kavionic/SAME70CPad/Schematics/Notes.ods

Sheet: Pin assignment
LQFP Pin | Primary |  |  | Alternate |  | PIO Peripheral A |  | PIO Peripheral B |  | PIO Peripheral C |  | PIO Peripheral D |  | Reset State
 | Signal | Peripheral | Peripheral Signal | Signal | Dir | Signal | Dir | Signal | Dir | Signal | Dir | Signal | Dir | Signal, Dir, PU, PD, HiZ, ST
102 | PA0 | SDRAM | SDRAM_BANK1 | WKUP0(1) | I | PWMC0_PWMH0 | O | TIOA0 | I/O | A17/BA1 | O | I2SC0_MCK | – | PIO,I,PU,ST
99 | PA1 | IMU | IMU_INT [IW] | WKUP1(1) | I | PWMC0_PWML0 | O | TIOB0 | I/O | A18 | O | I2SC0_CK | – | PIO,I,PU,ST
93 | PA2 | TOUCHSCR | CTP_INT [IW] | WKUP2(1) | I | PWMC0_PWMH1 | O | – | – | DATRG | I | – | – | PIO,I,PU,ST
91 | PA3 | TOUCHSCR | CTP_SDA | PIODC0(2) | I | TWD0 | I/O | LONCOL1 | I | PCK2 | O | – | – | PIO,I,PU,ST
77 | PA4 | TOUCHSCR | CTP_SCL | WKUP3/PIODC1(3) | I | TWCK0 | O | TCLK0 | I | UTXD1 | O | – | – | PIO,I,PU,ST
73 | PA5 | WIFI | WIFI_TX | WKUP4/PIODC2(3) | I | PWMC1_PWML3 | O | ISI_D4 | I | URXD1 | I | – | – | PIO,I,PU,ST
114 | PA6 | WIFI | WIFI_RX | – | – | – | – | PCK0 | O | UTXD1 | O | – | – | PIO,I,PU,ST
35 | PA7 | OSCILLATOR | Xtal 32768 | XIN32(4) | I | – | – | PWMC0_PWMH3 | O | – | – | – | – | PIO,HiZ
36 | PA8 | OSCILLATOR | Xtal 32768 | XOUT32(4) | O | PWMC1_PWMH3 | O | AFE0_ADTRG | I | – | – | – | – | PIO,HiZ
75 | PA9 | USB | VBUS_DETECT [IW] | WKUP6/PIODC3(3) | I | URXD0 | I | ISI_D3 | I | PWMC0_PWMFI0 | I | – | – | PIO,I,PU,ST
66 | PA10 | AUDIO | AUDIO_DOUT | PIODC4(2) | I | UTXD0 | O | PWMC0_PWMEXTRG0 | I | RD | I | – | – | PIO,I,PU,ST
64 | PA11 | FLASH | QSPI_CE | WKUP7/PIODC5(3) | I | QCS | O | PWMC0_PWMH0 | O | PWMC1_PWML0 | O | – | – | PIO,I,PU,ST
68 | PA12 | FLASH | QSPI_IO1 | PIODC6(2) | I | QIO1 | I/O | PWMC0_PWMH1 | O | PWMC1_PWMH0 | O | – | – | PIO,I,PU,ST
42 | PA13 | FLASH | QSPI_IO0 | PIODC7(2) | I | QIO0 | I/O | PWMC0_PWMH2 | O | PWMC1_PWML1 | O | – | – | PIO,I,PU,ST
51 | PA14 | FLASH | QSPI_SCK | WKUP8/PIODCEN1(3) | I | QSCK | O | PWMC0_PWMH3 | O | PWMC1_PWMH1 | O | – | – | PIO,I,PU,ST
49 | PA15 | SDRAM/LCD | DB14 | – | – | D14 | I/O | TIOA1 | I/O | PWMC0_PWML3 | O | I2SC0_WS | – | PIO,I,PU,ST
45 | PA16 | SDRAM/LCD | DB15 | – | – | D15 | I/O | TIOB1 | I/O | PWMC0_PWML2 | O | I2SC0_DI | – | PIO,I,PU,ST
25 | PA17 | FLASH | QSPI_IO2 | AFE0_AD6(5) | I | QIO2 | I/O | PCK1 | O | PWMC0_PWMH3 | O | – | – | PIO,I,PU,ST
24 | PA18 | SDRAM | AB14 | AFE0_AD7(5) | I | PWMC1_PWMEXTRG1 | I | PCK2 | O | A14 | O | – | – | PIO,I,PU,ST
23 | PA19 | SYSTEM | POWER_SW [IW] | AFE0_AD8/WKUP9(6) | I | – | – | PWMC0_PWML0 | O | A15 | O | I2SC1_MCK | – | PIO,I,PU,ST
22 | PA20 | SDRAM | SDRAM_BANK0 | AFE0_AD9/WKUP10(6) | I | – | – | PWMC0_PWML1 | O | A16/BA0 | O | I2SC1_CK | – | PIO,I,PU,ST
32 | PA21 | AUDIO | AUDIO_MCLK | AFE0_AD1/PIODCEN2(8) | I | RXD1 | I | PCK1 | O | PWMC1_PWMFI0 | I | – | – | PIO,I,PU,ST
37 | PA22 | TOUCHSCR | CTP_RESET [GPIO] | PIODCCLK(2) | I | RK | I/O | PWMC0_PWMEXTRG1 | I | NCS2 | O | – | – | PIO,I,PU,ST
46 | PA23 | TOUCHSCR | CTP_WAKE [GPIO] | – | – | SCK1 | I/O | PWMC0_PWMH0 | O | A19 | O | PWMC1_PWML2 | O | PIO,I,PU,ST
56 | PA24 | SDCARD | SDC_CD [GPIO] | – | – | RTS1 | O | PWMC0_PWMH1 | O | A20 | O | ISI_PCK | I | PIO,I,PU,ST
59 | PA25 | SDCARD | SDC_CLK | – | – | CTS1 | I | PWMC0_PWMH2 | O | A23 | O | MCCK | O | PIO,I,PU,ST
62 | PA26 | SDCARD | SDC_DATA2 | – | – | DCD1 | I | TIOA2 | O | MCDA2 | I/O | PWMC1_PWMFI1 | I | PIO,I,PU,ST
70 | PA27 | SDCARD | SDC_DATA3 | – | – | DTR1 | O | TIOB2 | I/O | MCDA3 | I/O | ISI_D7 | I | PIO,I,PU,ST
112 | PA28 | SDCARD | SDC_CMD | – | – | DSR1 | I | TCLK1 | I | MCCDA | I/O | PWMC1_PWMFI2 | I | PIO,I,PU,ST
129 | PA29 | IMU | IMU_FSYNC [GPIO] | – | – | RI1 | I | TCLK2 | I | – | – | – | – | PIO,I,PU,ST
116 | PA30 | SDCARD | SDC_DATA0 | WKUP11(1) | I | PWMC0_PWML2 | O | PWMC1_PWMEXTRG0 | I | MCDA0 | I/O | I2SC0_DO | – | PIO,I,PU,ST
118 | PA31 | SDCARD | SDC_DATA1 | – | – | SPI0_NPCS1 | I/O | PCK2 | O | MCDA1 | I/O | PWMC1_PWMH2 | O | PIO,I,PU,ST
21 | PB0 | AUDIO | AUDIO_WCLK | AFE0_AD10/RTCOUT0(7) | I | PWMC0_PWMH0 | O | – | – | RXD0 | I | TF | I/O | PIO,I,PU,ST
20 | PB1 | AUDIO | AUDIO_BCLK | AFE1_AD0/RTCOUT1(7) | I | PWMC0_PWMH1 | O | GTSUCOMP | O | TXD0 | I/O | TK | I/O | PIO,I,PU,ST
26 | PB2 | USB | VBUS_MEASURE [A] | AFE0_AD5(5) | I | CANTX0 | O | – | – | CTS0 | I | SPI0_NPCS0 | I/O | PIO,I,PU,ST
31 | PB3 | RF24 | RF24_IRQ [IW] | AFE0_AD2/WKUP12(6) | I | CANRX0 | I | PCK2 | O | RTS0 | O | ISI_D2 | I | PIO,I,PU,ST
105 | PB4 | SWD/JTAG | DBG_TDI | TDI(9) | I | TWD1 | I/O | PWMC0_PWMH2 | O | – | – | TXD1 | I/O | PIO,I,PD,ST
109 | PB5 | SWD/JTAG | DBG_TRACESWO | TDO/TRACESWO/WKUP13(9) | O | TWCK1 | O | PWMC0_PWML0 | O | – | – | TD | O | O,PU
79 | PB6 | SWD/JTAG | DBG_SWDIO | SWDIO/TMS(9) | I | – | – | – | – | – | – | – | – | PIO,I,ST
89 | PB7 | SWD/JTAG | DBG_SWCLK | SWCLK/TCK(9) | I | – | – | – | – | – | – | – | – | PIO,I,ST
141 | PB8 | OSCILLATOR | Xtal 12MHz | XOUT(10) | O | – | – | – | – | – | – | – | – | PIO,HiZ
142 | PB9 | OSCILLATOR | Xtal 12MHz | XIN(10) | I | – | – | – | – | – | – | – | – | PIO,HiZ
87 | PB12 | UDB | USB_ID [GPIO] | ERASE(9) | I | PWMC0_PWML1 | O | GTSUCOMP | O | – | – | PCK0 | O | PIO,I,PD,ST
144 | PB13 | VREF | VREF_SHDN [GPIO] | DAC0(11) | O | PWMC0_PWML2 | O | PCK0 | O | SCK0 | I/O | – | – | PIO,I,PU,ST
11 | PC0 | SDRAM/LCD | DB0 | AFE1_AD9(5) | I | D0 | I/O | PWMC0_PWML0 | O | – | – | – | – | PIO,I,PU,ST
38 | PC1 | SDRAM/LCD | DB1 | – | – | D1 | I/O | PWMC0_PWML1 | O | – | – | – | – | PIO,I,PU,ST
39 | PC2 | SDRAM/LCD | DB2 | – | – | D2 | I/O | PWMC0_PWML2 | O | – | – | – | – | PIO,I,PU,ST
40 | PC3 | SDRAM/LCD | DB3 | – | – | D3 | I/O | PWMC0_PWML3 | O | – | – | – | – | PIO,I,PU,ST
41 | PC4 | SDRAM/LCD | DB4 | – | – | D4 | I/O | – | – | – | – | – | – | PIO,I,PU,ST
58 | PC5 | SDRAM/LCD | DB5 | – | – | D5 | I/O | TIOA6 | I/O | – | – | – | – | PIO,I,PU,ST
54 | PC6 | SDRAM/LCD | DB6 | – | – | D6 | I/O | TIOB6 | I/O | – | – | – | – | PIO,I,PU,ST
48 | PC7 | SDRAM/LCD | DB7 | – | – | D7 | I/O | TCLK6 | I | – | – | – | – | PIO,I,PU,ST
82 | PC8 | LCD | LCD_WR | – | – | NWR0/NWE | O | TIOA7 | I/O | – | – | – | – | PIO,I,PU,ST
86 | PC9 | LCD | LCD_WAIT [GPIO] | – | – | NANDOE | O | TIOB7 | I/O | – | – | – | – | PIO,I,PU,ST
90 | PC10 | LCD | LCD_RESET [GPIO] | – | – | NANDWE | O | TCLK7 | I | – | – | – | – | PIO,I,PU,ST
94 | PC11 | LCD | LCD_RD | – | – | NRD | O | TIOA8 | I/O | – | – | – | – | PIO,I,PU,ST
17 | PC12 | LCD | LCD_CS | AFE1_AD3(5) | I | NCS3 | O | TIOB8 | I/O | CANRX1 | I | – | – | PIO,I,PU,ST
19 | PC13 | CHARGER | PWR_CHG_OTG [GPIO] | AFE1_AD1(5) | I | NWAIT | I | PWMC0_PWMH3 | O | SDA10 | O | – | – | PIO,I,PU,ST
97 | PC14 | LCD | LCD_INT [I] | – | – | NCS0 | O | TCLK8 | I | CANTX1 | O | – | – | PIO,I,PU,ST
18 | PC15 | SDRAM | SDRAM_CS | AFE1_AD2(5) | I | NCS1/SDCS | O | PWMC0_PWML3 | O | – | – | – | – | PIO,I,PU,ST
100 | PC16 | LCD | LCD_C86 [GPIO] | – | – | A21/NANDALE | O | – | – | – | – | – | – | PIO,I,PU,ST
103 | PC17 | CHARGER | PWR_CHG_INT [I] | – | – | A22/NANDCLE | O | – | – | – | – | – | – | PIO,I,PU,ST
111 | PC18 | SDRAM | DQML | – | – | A0/NBS0 | O | PWMC0_PWML1 | O | – | – | – | – | PIO,I,PU,ST
117 | PC19 | LCD | LCD_RS | – | – | A1 | O | PWMC0_PWMH2 | O | – | – | – | – | PIO,I,PU,ST
120 | PC20 | SDRAM | AB2 | – | – | A2 | O | PWMC0_PWML2 | O | – | – | – | – | PIO,I,PU,ST
122 | PC21 | SDRAM | AB3 | – | – | A3 | O | PWMC0_PWMH3 | O | – | – | – | – | PIO,I,PU,ST
124 | PC22 | SDRAM | AB4 | – | – | A4 | O | PWMC0_PWML3 | O | – | – | – | – | PIO,I,PU,ST
127 | PC23 | SDRAM | AB5 | – | – | A5 | O | TIOA3 | I/O | – | – | – | – | PIO,I,PU,ST
130 | PC24 | SDRAM | AB6 | – | – | A6 | O | TIOB3 | I/O | SPI1_SPCK | O | – | – | PIO,I,PU,ST
133 | PC25 | SDRAM | AB7 | – | – | A7 | O | TCLK3 | I | SPI1_NPCS0 | I/O | – | – | PIO,I,PU,ST
13 | PC26 | SDRAM | AB8 | AFE1_AD7(5) | I | A8 | O | TIOA4 | I/O | SPI1_MISO | I | – | – | PIO,I,PU,ST
12 | PC27 | SDRAM | AB9 | AFE1_AD8(5) | I | A9 | O | TIOB4 | I/O | SPI1_MOSI | O | – | – | PIO,I,PU,ST
76 | PC28 | SDRAM | AB10 | – | – | A10 | O | TCLK4 | I | SPI1_NPCS1 | I/O | – | – | PIO,I,PU,ST
16 | PC29 | SDRAM | AB11 | AFE1_AD4(5) | I | A11 | O | TIOA5 | I/O | SPI1_NPCS2 | O | – | – | PIO,I,PU,ST
15 | PC30 | AUDIO | AUDIO_INT [I] | AFE1_AD5(5) | I | A12 | O | TIOB5 | I/O | SPI1_NPCS3 | O | – | – | PIO,I,PU,ST
14 | PC31 | SDRAM | AB13 | AFE1_AD6(5) | I | A13 | O | TCLK5 | I | – | – | – | – | PIO,I,PU,ST
1 | PD0 | AUDIO | AUDIO_RESET [GPIO] | DAC1(11) | I | GTXCK | I | PWMC1_PWML0 | O | SPI1_NPCS1 | I/O | DCD0 | I | PIO,I,PU,ST
132 | PD1 | LED | LED_R | – | – | GTXEN | O | PWMC1_PWMH0 | O | SPI1_NPCS2 | I/O | DTR0 | O | PIO,I,PU,ST
131 | PD2 | WIFI | WIFI_RESET [GPIO] | – | – | GTX0 | O | PWMC1_PWML1 | O | SPI1_NPCS3 | I/O | DSR0 | I | PIO,I,PU,ST
128 | PD3 | LED | LED_G | – | – | GTX1 | O | PWMC1_PWMH1 | O | UTXD4 | O | RI0 | I | PIO,I,PU,ST
126 | PD4 | WIFI | WIFI_FLASH [GPIO] | – | – | GRXDV | I | PWMC1_PWML2 | O | TRACED0 | O | DCD2 | I | PIO,I,PU,ST
125 | PD5 | LED | LED_B | – | – | GRX0 | I | PWMC1_PWMH2 | O | TRACED1 | O | DTR2 | O | PIO,I,PU,ST
121 | PD6 | WIFI | WIFI_EN [GPIO] | – | – | GRX1 | I | PWMC1_PWML3 | O | TRACED2 | O | DSR2 | I | PIO,I,PU,ST
119 | PD7 | 3V3_REG | PWR_VREGMODE [GPIO] | – | – | GRXER | I | PWMC1_PWMH3 | O | TRACED3 | O | RI2 | I | PIO,I,PU,ST
113 | PD8 | 5V_REG | PWR_5VEN [GPIO] | – | – | GMDC | O | PWMC0_PWMFI1 | I | – | – | TRACECLK | O | PIO,I,PU,ST
110 | PD9 | CHARGER | PWR_CHG_CHG_ENABLE [GPIO] | – | – | GMDIO | I/O | PWMC0_PWMFI2 | I | AFE1_ADTRG | I | – | – | PIO,I,PU,ST
101 | PD10 | AUDIO | AUDIO_DIN | – | – | GCRS | I | PWMC0_PWML0 | O | TD | O | – | – | PIO,I,PD,ST
98 | PD11 | LCD | LCD_BL_CTRL [PWM] | – | – | GRX2 | I | PWMC0_PWMH0 | O | GTSUCOMP | O | ISI_D5 | I | PIO,I,PU,ST
92 | PD12 | RF24 | RF24_CE | – | – | GRX3 | I | CANTX1 | O | SPI0_NPCS2 | O | ISI_D6 | I | PIO,I,PU,ST
88 | PD13 | SDRAM | SDA10 | – | – | GCOL | I | – | – | SDA10 | O | – | – | PIO,I,PU,ST
84 | PD14 | SDRAM | SDRAM_CKE | – | – | GRXCK | I | – | – | SDCKE | O | – | – | PIO,I,PU,ST
106 | PD15 | SDRAM | DQMH | – | – | GTX2 | O | RXD2 | I | NWR1/NBS1 | O | – | – | PIO,I,PU,ST
78 | PD16 | SDRAM | SDRAM_RAS | – | – | GTX3 | O | TXD2 | I/O | RAS | O | – | – | PIO,I,PU,ST
74 | PD17 | SDRAM | SDRAM_CAS | – | – | GTXER | O | SCK2 | I/O | CAS | O | – | – | PIO,I,PU,ST
69 | PD18 | UART | DBGUART_RX | – | – | NCS1/SDCS | O | RTS2 | O | URXD4 | I | – | – | PIO,I,PU,ST
67 | PD19 | UART | DBGUART_TX | – | – | NCS3 | O | CTS2 | I | UTXD4 | O | – | – | PIO,I,PU,ST
65 | PD20 | RF24 | RF24_MISO | – | – | PWMC0_PWMH0 | O | SPI0_MISO | I/O | GTSUCOMP | O | – | – | PIO,I,PU,ST
63 | PD21 | RF24 | RF24_MOSI | – | – | PWMC0_PWMH1 | O | SPI0_MOSI | I/O | TIOA11 | I/O | ISI_D1 | I | PIO,I,PU,ST
60 | PD22 | RF24 | RF24_SCK | – | – | PWMC0_PWMH2 | O | SPI0_SPCK | O | TIOB11 | I/O | ISI_D0 | I | PIO,I,PU,ST
57 | PD23 | SDRAM | SDRAM_CLK | – | – | PWMC0_PWMH3 | O | – | – | SDCK | O | – | – | PIO,I,PU,ST
55 | PD24 | FLASH | QSPI_RESET [GPIO] | – | – | PWMC0_PWML0 | O | RF | I/O | TCLK11 | I | ISI_HSYNC | I | PIO,I,PU,ST
52 | PD25 | RF24 | RF24_CSN | – | – | PWMC0_PWML1 | O | SPI0_NPCS1 | I/O | URXD2 | I | ISI_VSYNC | I | PIO,I,PU,ST
53 | PD26 | ISENS | ISENS_WARNING [I] | – | – | PWMC0_PWML2 | O | TD | O | UTXD2 | O | UTXD1 | O | PIO,I,PU,ST
47 | PD27 | I2CBUS | I2CBUS2_SDA | – | – | PWMC0_PWML3 | O | SPI0_NPCS3 | O | TWD2 | O | ISI_D8 | I | PIO,I,PU,ST
71 | PD28 | I2CBUS | I2CBUS2_SCL | WKUP5(1) | I | URXD3 | I | CANRX1 | I | TWCK2 | O | ISI_D9 | I | PIO,I,PU,ST
108 | PD29 | SDRAM | SDRAM_WE | – | – | – | – | – | – | SDWE | O | – | – | PIO,I,PU,ST
34 | PD30 | ISENS | ISENS_CRITICAL [I] | AFE0_AD0(5) | I | UTXD3 | 0 | – | – | – | – | ISI_D10 | I | PIO,I,PU,ST
2 | PD31 | FLASH | QSPI_IO3 | – | – | QIO3 | I/O | UTXD3 | O | PCK2 | O | ISI_D11 | I | PIO,I,PU,ST
4 | PE0 | SDRAM/LCD | DB8 | AFE1_AD11(5) | I | D8 | I/O | TIOA9 | I/O | I2SC1_WS | – | – | – | PIO,I,PU,ST
6 | PE1 | SDRAM/LCD | DB9 | – | – | D9 | I/O | TIOB9 | I/O | I2SC1_DO | – | – | – | PIO,I,PU,ST
7 | PE2 | SDRAM/LCD | DB10 | – | – | D10 | I/O | TCLK9 | I | I2SC1_DI | – | – | – | PIO,I,PU,ST
10 | PE3 | SDRAM/LCD | DB11 | AFE1_AD10(5) | I | D11 | I/O | TIOA10 | I/O | – | – | – | – | PIO,I,PU,ST
27 | PE4 | SDRAM/LCD | DB12 | AFE0_AD4(5) | I | D12 | I/O | TIOB10 | I/O | – | – | – | – | PIO,I,PU,ST
28 | PE5 | SDRAM/LCD | DB13 | AFE0_AD3(5) | I | D13 | I/O | TCLK10 | I/O | – | – | – | – | PIO,I,PU,ST
3 | VDDOUT | POWER |  | – | – | – | – | – | – | – | – | – | – | –
5 | VDDIN | POWER |  | – | – | – | – | – | – | – | – | – | – | –
8 | VREFN | VREF |  | – | – | – | – | – | – | – | – | – | – | –
9 | VREFP | VREF |  | – | – | – | – | – | – | – | – | – | – | –
83 | NRST | SYSTEM | RESET | – | – | – | – | – | – | – | – | – | – | I,PU
85 | TST | SYSTEM | TST | – | – | – | – | – | – | – | – | – | – | I,PD
30,43,72, 80,96 | VDDIO | POWER |  | – | – | – | – | – | – | – | – | – | – | –
104 | JTAGSEL | SYSTEM | JTAGSEL | – | – | – | – | – | – | – | – | – | – | I,PD
29,33,50, 81,107 | VDDCORE | POWER |  | – | – | – | – | – | – | – | – | – | – | –
123 | VDDPLL | POWER |  | – | – | – | – | – | – | – | – | – | – | –
134 | VDDUTMII | POWER |  | – | – | – | – | – | – | – | – | – | – | –
136 | HSDM | USB | USB_D- | – | – | – | – | – | – | – | – | – | – | –
137 | HSDP | USB | USB_D+ | – | – | – | – | – | – | – | – | – | – | –
44,61,95, 115,135,138 | GND | POWER |  | – | – | – | – | – | – | – | – | – | – | –
– | GNDANA | POWER |  | – | – | – | – | – | – | – | – | – | – | –
– | GNDUTMI | POWER |  | – | – | – | – | – | – | – | – | – | – | –
– | GNDPLLUSB | POWER |  | – | – | – | – | – | – | – | – | – | – | –
– | GNDPLL | POWER |  | – | – | – | – | – | – | – | – | – | – | –
139 | VDDUTMIC | POWER |  | – | – | – | – | – | – | – | – | – | – | –
140 | VBG | POWER |  | – | – | – | – | – | – | – | – | – | – | –
143 | VDDPLLUSB | POWER |  | – | – | – | – | – | – | – | – | – | – | –

Sheet: PinAss Periph
LQFP Pin | Primary |  |  | Alternate |  | PIO Peripheral A |  | PIO Peripheral B |  | PIO Peripheral C |  | PIO Peripheral D |  | Reset State
 | Signal | Peripheral | Peripheral Signal | Signal | Dir | Signal | Dir | Signal | Dir | Signal | Dir | Signal | Dir | Signal, Dir, PU, PD, HiZ, ST
119 | PD7 | 3V3_REG | PWR_VREGMODE [GPIO] | – | – | GRXER | I | PWMC1_PWMH3 | O | TRACED3 | O | RI2 | I | PIO,I,PU,ST
113 | PD8 | 5V_REG | PWR_5VEN [GPIO] | – | – | GMDC | O | PWMC0_PWMFI1 | I | – | – | TRACECLK | O | PIO,I,PU,ST
20 | PB1 | AUDIO | AUDIO_BCLK | AFE1_AD0/RTCOUT1(7) | I | PWMC0_PWMH1 | O | GTSUCOMP | O | TXD0 | I/O | TK | I/O | PIO,I,PU,ST
101 | PD10 | AUDIO | AUDIO_DIN | – | – | GCRS | I | PWMC0_PWML0 | O | TD | O | – | – | PIO,I,PD,ST
66 | PA10 | AUDIO | AUDIO_DOUT | PIODC4(2) | I | UTXD0 | O | PWMC0_PWMEXTRG0 | I | RD | I | – | – | PIO,I,PU,ST
15 | PC30 | AUDIO | AUDIO_INT [I] | AFE1_AD5(5) | I | A12 | O | TIOB5 | I/O | SPI1_NPCS3 | O | – | – | PIO,I,PU,ST
32 | PA21 | AUDIO | AUDIO_MCLK | AFE0_AD1/PIODCEN2(8) | I | RXD1 | I | PCK1 | O | PWMC1_PWMFI0 | I | – | – | PIO,I,PU,ST
1 | PD0 | AUDIO | AUDIO_RESET [GPIO] | DAC1(11) | I | GTXCK | I | PWMC1_PWML0 | O | SPI1_NPCS1 | I/O | DCD0 | I | PIO,I,PU,ST
21 | PB0 | AUDIO | AUDIO_WCLK | AFE0_AD10/RTCOUT0(7) | I | PWMC0_PWMH0 | O | – | – | RXD0 | I | TF | I/O | PIO,I,PU,ST
110 | PD9 | CHARGER | PWR_CHG_CHG_ENABLE [GPIO] | – | – | GMDIO | I/O | PWMC0_PWMFI2 | I | AFE1_ADTRG | I | – | – | PIO,I,PU,ST
103 | PC17 | CHARGER | PWR_CHG_INT [I] | – | – | A22/NANDCLE | O | – | – | – | – | – | – | PIO,I,PU,ST
19 | PC13 | CHARGER | PWR_CHG_OTG [GPIO] | AFE1_AD1(5) | I | NWAIT | I | PWMC0_PWMH3 | O | SDA10 | O | – | – | PIO,I,PU,ST
64 | PA11 | FLASH | QSPI_CE | WKUP7/PIODC5(3) | I | QCS | O | PWMC0_PWMH0 | O | PWMC1_PWML0 | O | – | – | PIO,I,PU,ST
42 | PA13 | FLASH | QSPI_IO0 | PIODC7(2) | I | QIO0 | I/O | PWMC0_PWMH2 | O | PWMC1_PWML1 | O | – | – | PIO,I,PU,ST
68 | PA12 | FLASH | QSPI_IO1 | PIODC6(2) | I | QIO1 | I/O | PWMC0_PWMH1 | O | PWMC1_PWMH0 | O | – | – | PIO,I,PU,ST
25 | PA17 | FLASH | QSPI_IO2 | AFE0_AD6(5) | I | QIO2 | I/O | PCK1 | O | PWMC0_PWMH3 | O | – | – | PIO,I,PU,ST
2 | PD31 | FLASH | QSPI_IO3 | – | – | QIO3 | I/O | UTXD3 | O | PCK2 | O | ISI_D11 | I | PIO,I,PU,ST
55 | PD24 | FLASH | QSPI_RESET [GPIO] | – | – | PWMC0_PWML0 | O | RF | I/O | TCLK11 | I | ISI_HSYNC | I | PIO,I,PU,ST
51 | PA14 | FLASH | QSPI_SCK | WKUP8/PIODCEN1(3) | I | QSCK | O | PWMC0_PWMH3 | O | PWMC1_PWMH1 | O | – | – | PIO,I,PU,ST
71 | PD28 | I2CBUS | I2CBUS2_SCL | WKUP5(1) | I | URXD3 | I | CANRX1 | I | TWCK2 | O | ISI_D9 | I | PIO,I,PU,ST
47 | PD27 | I2CBUS | I2CBUS2_SDA | – | – | PWMC0_PWML3 | O | SPI0_NPCS3 | O | TWD2 | O | ISI_D8 | I | PIO,I,PU,ST
129 | PA29 | IMU | IMU_FSYNC [GPIO] | – | – | RI1 | I | TCLK2 | I | – | – | – | – | PIO,I,PU,ST
99 | PA1 | IMU | IMU_INT [IW] | WKUP1(1) | I | PWMC0_PWML0 | O | TIOB0 | I/O | A18 | O | I2SC0_CK | – | PIO,I,PU,ST
34 | PD30 | ISENS | ISENS_CRITICAL [I] | AFE0_AD0(5) | I | UTXD3 | 0 | – | – | – | – | ISI_D10 | I | PIO,I,PU,ST
53 | PD26 | ISENS | ISENS_WARNING [I] | – | – | PWMC0_PWML2 | O | TD | O | UTXD2 | O | UTXD1 | O | PIO,I,PU,ST
125 | PD5 | LED | LED_B | – | – | GRX0 | I | PWMC1_PWMH2 | O | TRACED1 | O | DTR2 | O | PIO,I,PU,ST
128 | PD3 | LED | LED_G | – | – | GTX1 | O | PWMC1_PWMH1 | O | UTXD4 | O | RI0 | I | PIO,I,PU,ST
132 | PD1 | LED | LED_R | – | – | GTXEN | O | PWMC1_PWMH0 | O | SPI1_NPCS2 | I/O | DTR0 | O | PIO,I,PU,ST
141 | PB8 | OSCILLATOR | Xtal 12MHz | XOUT(10) | O | – | – | – | – | – | – | – | – | PIO,HiZ
142 | PB9 | OSCILLATOR | Xtal 12MHz | XIN(10) | I | – | – | – | – | – | – | – | – | PIO,HiZ
35 | PA7 | OSCILLATOR | Xtal 32768 | XIN32(4) | I | – | – | PWMC0_PWMH3 | O | – | – | – | – | PIO,HiZ
36 | PA8 | OSCILLATOR | Xtal 32768 | XOUT32(4) | O | PWMC1_PWMH3 | O | AFE0_ADTRG | I | – | – | – | – | PIO,HiZ
140 | VBG | POWER |  | – | – | – | – | – | – | – | – | – | – | –
92 | PD12 | RF24 | RF24_CE | – | – | GRX3 | I | CANTX1 | O | SPI0_NPCS2 | O | ISI_D6 | I | PIO,I,PU,ST
52 | PD25 | RF24 | RF24_CSN | – | – | PWMC0_PWML1 | O | SPI0_NPCS1 | I/O | URXD2 | I | ISI_VSYNC | I | PIO,I,PU,ST
31 | PB3 | RF24 | RF24_IRQ [IW] | AFE0_AD2/WKUP12(6) | I | CANRX0 | I | PCK2 | O | RTS0 | O | ISI_D2 | I | PIO,I,PU,ST
65 | PD20 | RF24 | RF24_MISO | – | – | PWMC0_PWMH0 | O | SPI0_MISO | I/O | GTSUCOMP | O | – | – | PIO,I,PU,ST
63 | PD21 | RF24 | RF24_MOSI | – | – | PWMC0_PWMH1 | O | SPI0_MOSI | I/O | TIOA11 | I/O | ISI_D1 | I | PIO,I,PU,ST
60 | PD22 | RF24 | RF24_SCK | – | – | PWMC0_PWMH2 | O | SPI0_SPCK | O | TIOB11 | I/O | ISI_D0 | I | PIO,I,PU,ST
56 | PA24 | SDCARD | SDC_CD [GPIO] | – | – | RTS1 | O | PWMC0_PWMH1 | O | A20 | O | ISI_PCK | I | PIO,I,PU,ST
59 | PA25 | SDCARD | SDC_CLK | – | – | CTS1 | I | PWMC0_PWMH2 | O | A23 | O | MCCK | O | PIO,I,PU,ST
112 | PA28 | SDCARD | SDC_CMD | – | – | DSR1 | I | TCLK1 | I | MCCDA | I/O | PWMC1_PWMFI2 | I | PIO,I,PU,ST
116 | PA30 | SDCARD | SDC_DATA0 | WKUP11(1) | I | PWMC0_PWML2 | O | PWMC1_PWMEXTRG0 | I | MCDA0 | I/O | I2SC0_DO | – | PIO,I,PU,ST
118 | PA31 | SDCARD | SDC_DATA1 | – | – | SPI0_NPCS1 | I/O | PCK2 | O | MCDA1 | I/O | PWMC1_PWMH2 | O | PIO,I,PU,ST
62 | PA26 | SDCARD | SDC_DATA2 | – | – | DCD1 | I | TIOA2 | O | MCDA2 | I/O | PWMC1_PWMFI1 | I | PIO,I,PU,ST
70 | PA27 | SDCARD | SDC_DATA3 | – | – | DTR1 | O | TIOB2 | I/O | MCDA3 | I/O | ISI_D7 | I | PIO,I,PU,ST
120 | PC20 | SDRAM | AB2 (A0) | – | – | A2 | O | PWMC0_PWML2 | O | – | – | – | – | PIO,I,PU,ST
122 | PC21 | SDRAM | AB3 (A1) | – | – | A3 | O | PWMC0_PWMH3 | O | – | – | – | – | PIO,I,PU,ST
124 | PC22 | SDRAM | AB4 (A2) | – | – | A4 | O | PWMC0_PWML3 | O | – | – | – | – | PIO,I,PU,ST
127 | PC23 | SDRAM | AB5 (A3) | – | – | A5 | O | TIOA3 | I/O | – | – | – | – | PIO,I,PU,ST
130 | PC24 | SDRAM | AB6 (A4) | – | – | A6 | O | TIOB3 | I/O | SPI1_SPCK | O | – | – | PIO,I,PU,ST
133 | PC25 | SDRAM | AB7 (A5) | – | – | A7 | O | TCLK3 | I | SPI1_NPCS0 | I/O | – | – | PIO,I,PU,ST
13 | PC26 | SDRAM | AB8 (A6) | AFE1_AD7(5) | I | A8 | O | TIOA4 | I/O | SPI1_MISO | I | – | – | PIO,I,PU,ST
12 | PC27 | SDRAM | AB9 (A7) | AFE1_AD8(5) | I | A9 | O | TIOB4 | I/O | SPI1_MOSI | O | – | – | PIO,I,PU,ST
76 | PC28 | SDRAM | AB10 (A8) | – | – | A10 | O | TCLK4 | I | SPI1_NPCS1 | I/O | – | – | PIO,I,PU,ST
16 | PC29 | SDRAM | AB11 (A9) | AFE1_AD4(5) | I | A11 | O | TIOA5 | I/O | SPI1_NPCS2 | O | – | – | PIO,I,PU,ST
88 | PD13 | SDRAM | SDA10 (A10) | – | – | GCOL | I | – | – | SDA10 | O | – | – | PIO,I,PU,ST
14 | PC31 | SDRAM | AB13 (A11) | AFE1_AD6(5) | I | A13 | O | TCLK5 | I | – | – | – | – | PIO,I,PU,ST
24 | PA18 | SDRAM | AB14 (A12) | AFE0_AD7(5) | I | PWMC1_PWMEXTRG1 | I | PCK2 | O | A14 | O | – | – | PIO,I,PU,ST
106 | PD15 | SDRAM | DQMH | – | – | GTX2 | O | RXD2 | I | NWR1/NBS1 | O | – | – | PIO,I,PU,ST
111 | PC18 | SDRAM | DQML | – | – | A0/NBS0 | O | PWMC0_PWML1 | O | – | – | – | – | PIO,I,PU,ST
22 | PA20 | SDRAM | SDRAM_BANK0 | AFE0_AD9/WKUP10(6) | I | – | – | PWMC0_PWML1 | O | A16/BA0 | O | I2SC1_CK | – | PIO,I,PU,ST
102 | PA0 | SDRAM | SDRAM_BANK1 | WKUP0(1) | I | PWMC0_PWMH0 | O | TIOA0 | I/O | A17/BA1 | O | I2SC0_MCK | – | PIO,I,PU,ST
74 | PD17 | SDRAM | SDRAM_CAS | – | – | GTXER | O | SCK2 | I/O | CAS | O | – | – | PIO,I,PU,ST
84 | PD14 | SDRAM | SDRAM_CKE | – | – | GRXCK | I | – | – | SDCKE | O | – | – | PIO,I,PU,ST
57 | PD23 | SDRAM | SDRAM_CLK | – | – | PWMC0_PWMH3 | O | – | – | SDCK | O | – | – | PIO,I,PU,ST
18 | PC15 | SDRAM | SDRAM_CS | AFE1_AD2(5) | I | NCS1/SDCS | O | PWMC0_PWML3 | O | – | – | – | – | PIO,I,PU,ST
78 | PD16 | SDRAM | SDRAM_RAS | – | – | GTX3 | O | TXD2 | I/O | RAS | O | – | – | PIO,I,PU,ST
108 | PD29 | SDRAM | SDRAM_WE | – | – | – | – | – | – | SDWE | O | – | – | PIO,I,PU,ST
11 | PC0 | SDRAM/LCD | DB0 | AFE1_AD9(5) | I | D0 | I/O | PWMC0_PWML0 | O | – | – | – | – | PIO,I,PU,ST
38 | PC1 | SDRAM/LCD | DB1 | – | – | D1 | I/O | PWMC0_PWML1 | O | – | – | – | – | PIO,I,PU,ST
39 | PC2 | SDRAM/LCD | DB2 | – | – | D2 | I/O | PWMC0_PWML2 | O | – | – | – | – | PIO,I,PU,ST
40 | PC3 | SDRAM/LCD | DB3 | – | – | D3 | I/O | PWMC0_PWML3 | O | – | – | – | – | PIO,I,PU,ST
41 | PC4 | SDRAM/LCD | DB4 | – | – | D4 | I/O | – | – | – | – | – | – | PIO,I,PU,ST
58 | PC5 | SDRAM/LCD | DB5 | – | – | D5 | I/O | TIOA6 | I/O | – | – | – | – | PIO,I,PU,ST
54 | PC6 | SDRAM/LCD | DB6 | – | – | D6 | I/O | TIOB6 | I/O | – | – | – | – | PIO,I,PU,ST
48 | PC7 | SDRAM/LCD | DB7 | – | – | D7 | I/O | TCLK6 | I | – | – | – | – | PIO,I,PU,ST
4 | PE0 | SDRAM/LCD | DB8 | AFE1_AD11(5) | I | D8 | I/O | TIOA9 | I/O | I2SC1_WS | – | – | – | PIO,I,PU,ST
6 | PE1 | SDRAM/LCD | DB9 | – | – | D9 | I/O | TIOB9 | I/O | I2SC1_DO | – | – | – | PIO,I,PU,ST
7 | PE2 | SDRAM/LCD | DB10 | – | – | D10 | I/O | TCLK9 | I | I2SC1_DI | – | – | – | PIO,I,PU,ST
10 | PE3 | SDRAM/LCD | DB11 | AFE1_AD10(5) | I | D11 | I/O | TIOA10 | I/O | – | – | – | – | PIO,I,PU,ST
27 | PE4 | SDRAM/LCD | DB12 | AFE0_AD4(5) | I | D12 | I/O | TIOB10 | I/O | – | – | – | – | PIO,I,PU,ST
28 | PE5 | SDRAM/LCD | DB13 | AFE0_AD3(5) | I | D13 | I/O | TCLK10 | I/O | – | – | – | – | PIO,I,PU,ST
49 | PA15 | SDRAM/LCD | DB14 | – | – | D14 | I/O | TIOA1 | I/O | PWMC0_PWML3 | O | I2SC0_WS | – | PIO,I,PU,ST
45 | PA16 | SDRAM/LCD | DB15 | – | – | D15 | I/O | TIOB1 | I/O | PWMC0_PWML2 | O | I2SC0_DI | – | PIO,I,PU,ST
98 | PD11 | LCD | LCD_BL_CTRL [PWM] | – | – | GRX2 | I | PWMC0_PWMH0 | O | GTSUCOMP | O | ISI_D5 | I | PIO,I,PU,ST
100 | PC16 | LCD | LCD_C86 [GPIO] | – | – | A21/NANDALE | O | – | – | – | – | – | – | PIO,I,PU,ST
17 | PC12 | LCD | LCD_CS | AFE1_AD3(5) | I | NCS3 | O | TIOB8 | I/O | CANRX1 | I | – | – | PIO,I,PU,ST
97 | PC14 | LCD | LCD_INT [I] | – | – | NCS0 | O | TCLK8 | I | CANTX1 | O | – | – | PIO,I,PU,ST
94 | PC11 | LCD | LCD_RD | – | – | NRD | O | TIOA8 | I/O | – | – | – | – | PIO,I,PU,ST
90 | PC10 | LCD | LCD_RESET [GPIO] | – | – | NANDWE | O | TCLK7 | I | – | – | – | – | PIO,I,PU,ST
117 | PC19 | LCD | LCD_RS | – | – | A1 | O | PWMC0_PWMH2 | O | – | – | – | – | PIO,I,PU,ST
86 | PC9 | LCD | LCD_WAIT [GPIO] | – | – | NANDOE | O | TIOB7 | I/O | – | – | – | – | PIO,I,PU,ST
82 | PC8 | LCD | LCD_WR | – | – | NWR0/NWE | O | TIOA7 | I/O | – | – | – | – | PIO,I,PU,ST
89 | PB7 | SWD/JTAG | DBG_SWCLK | SWCLK/TCK(9) | I | – | – | – | – | – | – | – | – | PIO,I,ST
79 | PB6 | SWD/JTAG | DBG_SWDIO | SWDIO/TMS(9) | I | – | – | – | – | – | – | – | – | PIO,I,ST
105 | PB4 | SWD/JTAG | DBG_TDI | TDI(9) | I | TWD1 | I/O | PWMC0_PWMH2 | O | – | – | TXD1 | I/O | PIO,I,PD,ST
109 | PB5 | SWD/JTAG | DBG_TRACESWO | TDO/TRACESWO/WKUP13(9) | O | TWCK1 | O | PWMC0_PWML0 | O | – | – | TD | O | O,PU
104 | JTAGSEL | SYSTEM | JTAGSEL | – | – | – | – | – | – | – | – | – | – | I,PD
23 | PA19 | SYSTEM | POWER_SW [IW] | AFE0_AD8/WKUP9(6) | I | – | – | PWMC0_PWML0 | O | A15 | O | I2SC1_MCK | – | PIO,I,PU,ST
83 | NRST | SYSTEM | RESET | – | – | – | – | – | – | – | – | – | – | I,PU
85 | TST | SYSTEM | TST | – | – | – | – | – | – | – | – | – | – | I,PD
93 | PA2 | TOUCHSCR | CTP_INT [IW] | WKUP2(1) | I | PWMC0_PWMH1 | O | – | – | DATRG | I | – | – | PIO,I,PU,ST
37 | PA22 | TOUCHSCR | CTP_RESET [GPIO] | PIODCCLK(2) | I | RK | I/O | PWMC0_PWMEXTRG1 | I | NCS2 | O | – | – | PIO,I,PU,ST
77 | PA4 | TOUCHSCR | CTP_SCL | WKUP3/PIODC1(3) | I | TWCK0 | O | TCLK0 | I | UTXD1 | O | – | – | PIO,I,PU,ST
91 | PA3 | TOUCHSCR | CTP_SDA | PIODC0(2) | I | TWD0 | I/O | LONCOL1 | I | PCK2 | O | – | – | PIO,I,PU,ST
46 | PA23 | TOUCHSCR | CTP_WAKE [GPIO] | – | – | SCK1 | I/O | PWMC0_PWMH0 | O | A19 | O | PWMC1_PWML2 | O | PIO,I,PU,ST
69 | PD18 | UART | DBGUART_RX | – | – | NCS1/SDCS | O | RTS2 | O | URXD4 | I | – | – | PIO,I,PU,ST
67 | PD19 | UART | DBGUART_TX | – | – | NCS3 | O | CTS2 | I | UTXD4 | O | – | – | PIO,I,PU,ST
87 | PB12 | UDB | USB_ID [GPIO] | ERASE(9) | I | PWMC0_PWML1 | O | GTSUCOMP | O | – | – | PCK0 | O | PIO,I,PD,ST
136 | HSDM | USB | USB_D- | – | – | – | – | – | – | – | – | – | – | –
137 | HSDP | USB | USB_D+ | – | – | – | – | – | – | – | – | – | – | –
75 | PA9 | USB | VBUS_DETECT [IW] | WKUP6/PIODC3(3) | I | URXD0 | I | ISI_D3 | I | PWMC0_PWMFI0 | I | – | – | PIO,I,PU,ST
26 | PB2 | USB | VBUS_MEASURE [A] | AFE0_AD5(5) | I | CANTX0 | O | – | – | CTS0 | I | SPI0_NPCS0 | I/O | PIO,I,PU,ST
144 | PB13 | VREF | VREF_SHDN [GPIO] | DAC0(11) | O | PWMC0_PWML2 | O | PCK0 | O | SCK0 | I/O | – | – | PIO,I,PU,ST
8 | VREFN | VREF |  | – | – | – | – | – | – | – | – | – | – | –
9 | VREFP | VREF |  | – | – | – | – | – | – | – | – | – | – | –
121 | PD6 | WIFI | WIFI_EN [GPIO] | – | – | GRX1 | I | PWMC1_PWML3 | O | TRACED2 | O | DSR2 | I | PIO,I,PU,ST
126 | PD4 | WIFI | WIFI_FLASH [GPIO] | – | – | GRXDV | I | PWMC1_PWML2 | O | TRACED0 | O | DCD2 | I | PIO,I,PU,ST
131 | PD2 | WIFI | WIFI_RESET [GPIO] | – | – | GTX0 | O | PWMC1_PWML1 | O | SPI1_NPCS3 | I/O | DSR0 | I | PIO,I,PU,ST
114 | PA6 | WIFI | WIFI_RX | – | – | – | – | PCK0 | O | UTXD1 | O | – | – | PIO,I,PU,ST
73 | PA5 | WIFI | WIFI_TX | WKUP4/PIODC2(3) | I | PWMC1_PWML3 | O | ISI_D4 | I | URXD1 | I | – | – | PIO,I,PU,ST

Sheet: Notes
Device | Part Nr. | DigiKey Part Nr. | Manufacturer | I2C Address
IMU | MPU-9250 |  | TDK InvenSense | 0x68/0x69 + 0x0c (magnetometer)
Temp / Humidity / Pressure | BME280 |  | BOSCH | 0x76 / 0x77
USB battery charger | bq24297 |  | Texas Instruments | 0x6b
Current sense | PAC1720-1-AIA-TR | PAC1720-1-AIA-CT-ND | Microchip Technology | 0x18 (Res selected)
1.8V Regulator | AP2138N-1.8TRG1 | AP2138N-1.8TRG1DICT-ND | Diodes Incorporated | NA
2.5V voltage reference | MCP1501T-25E/CHY | MCP1501T-25E/CHYCT-ND | Microchip Technology | NA
Headphone connector | SJ-43514-SMT-TR | CP-43514SJCT-ND | CUI Inc. | NA
Microphone | ICS-40181 | 1428-1065-1-ND | TDK InvenSense | NA

Sheet: Pinout
LQFP Pin | LFBGA Ball | UFBGA Ball | Power Rail | I/O Type | Primary |  | Alternate |  | PIO Peripheral A |  | PIO Peripheral B |  | PIO Peripheral C |  | PIO Peripheral D |  | Reset State
 |  |  |  |  | Signal | Dir | Signal | Dir | Signal | Dir | Signal | Dir | Signal | Dir | Signal | Dir | Signal, Dir, PU, PD, HiZ, ST
102 | C11 | E11 | VDDIO | GPIO_AD | PA0 | I/O | WKUP0(1) | I | PWMC0_PWMH0 | O | TIOA0 | I/O | A17/BA1 | O | I2SC0_MCK | – | PIO,I,PU,ST
99 | D12 | F11 | VDDIO | GPIO_AD | PA1 | I/O | WKUP1(1) | I | PWMC0_PWML0 | O | TIOB0 | I/O | A18 | O | I2SC0_CK | – | PIO,I,PU,ST
93 | E12 | G12 | VDDIO | GPIO | PA2 | I/O | WKUP2(1) | I | PWMC0_PWMH1 | O | – | – | DATRG | I | – | – | PIO,I,PU,ST
91 | F12 | G11 | VDDIO | GPIO_AD | PA3 | I/O | PIODC0(2) | I | TWD0 | I/O | LONCOL1 | I | PCK2 | O | – | – | PIO,I,PU,ST
77 | K12 | L12 | VDDIO | GPIO | PA4 | I/O | WKUP3/PIODC1(3) | I | TWCK0 | O | TCLK0 | I | UTXD1 | O | – | – | PIO,I,PU,ST
73 | M11 | N13 | VDDIO | GPIO_AD | PA5 | I/O | WKUP4/PIODC2(3) | I | PWMC1_PWML3 | O | ISI_D4 | I | URXD1 | I | – | – | PIO,I,PU,ST
114 | B9 | B11 | VDDIO | GPIO_AD | PA6 | I/O | – | – | – | – | PCK0 | O | UTXD1 | O | – | – | PIO,I,PU,ST
35 | L2 | N1 | VDDIO | CLOCK | PA7 | I/O | XIN32(4) | I | – | – | PWMC0_PWMH3 | O | – | – | – | – | PIO,HiZ
36 | M2 | N2 | VDDIO | CLOCK | PA8 | I/O | XOUT32(4) | O | PWMC1_PWMH3 | O | AFE0_ADTRG | I | – | – | – | – | PIO,HiZ
75 | M12 | L11 | VDDIO | GPIO_AD | PA9 | I/O | WKUP6/PIODC3(3) | I | URXD0 | I | ISI_D3 | I | PWMC0_PWMFI0 | I | – | – | PIO,I,PU,ST
66 | L9 | M10 | VDDIO | GPIO_AD | PA10 | I/O | PIODC4(2) | I | UTXD0 | O | PWMC0_PWMEXTRG0 | I | RD | I | – | – | PIO,I,PU,ST
64 | J9 | N10 | VDDIO | GPIO_AD | PA11 | I/O | WKUP7/PIODC5(3) | I | QCS | O | PWMC0_PWMH0 | O | PWMC1_PWML0 | O | – | – | PIO,I,PU,ST
68 | L10 | N11 | VDDIO | GPIO_AD | PA12 | I/O | PIODC6(2) | I | QIO1 | I/O | PWMC0_PWMH1 | O | PWMC1_PWMH0 | O | – | – | PIO,I,PU,ST
42 | M3 | M4 | VDDIO | GPIO_AD | PA13 | I/O | PIODC7(2) | I | QIO0 | I/O | PWMC0_PWMH2 | O | PWMC1_PWML1 | O | – | – | PIO,I,PU,ST
51 | K6 | M6 | VDDIO | GPIO_CLK | PA14 | I/O | WKUP8/PIODCEN1(3) | I | QSCK | O | PWMC0_PWMH3 | O | PWMC1_PWMH1 | O | – | – | PIO,I,PU,ST
49 | L5 | N6 | VDDIO | GPIO_AD | PA15 | I/O | – | – | D14 | I/O | TIOA1 | I/O | PWMC0_PWML3 | O | I2SC0_WS | – | PIO,I,PU,ST
45 | K5 | L4 | VDDIO | GPIO_AD | PA16 | I/O | – | – | D15 | I/O | TIOB1 | I/O | PWMC0_PWML2 | O | I2SC0_DI | – | PIO,I,PU,ST
25 | J1 | J4 | VDDIO | GPIO_AD | PA17 | I/O | AFE0_AD6(5) | I | QIO2 | I/O | PCK1 | O | PWMC0_PWMH3 | O | – | – | PIO,I,PU,ST
24 | H2 | J3 | VDDIO | GPIO_AD | PA18 | I/O | AFE0_AD7(5) | I | PWMC1_PWMEXTRG1 | I | PCK2 | O | A14 | O | – | – | PIO,I,PU,ST
23 | H1 | J2 | VDDIO | GPIO_AD | PA19 | I/O | AFE0_AD8/WKUP9(6) | I | – | – | PWMC0_PWML0 | O | A15 | O | I2SC1_MCK | – | PIO,I,PU,ST
22 | H3 | J1 | VDDIO | GPIO_AD | PA20 | I/O | AFE0_AD9/WKUP10(6) | I | – | – | PWMC0_PWML1 | O | A16/BA0 | O | I2SC1_CK | – | PIO,I,PU,ST
32 | K2 | M1 | VDDIO | GPIO_AD | PA21 | I/O | AFE0_AD1/PIODCEN2(8) | I | RXD1 | I | PCK1 | O | PWMC1_PWMFI0 | I | – | – | PIO,I,PU,ST
37 | K3 | M2 | VDDIO | GPIO_AD | PA22 | I/O | PIODCCLK(2) | I | RK | I/O | PWMC0_PWMEXTRG1 | I | NCS2 | O | – | – | PIO,I,PU,ST
46 | L4 | N5 | VDDIO | GPIO_AD | PA23 | I/O | – | – | SCK1 | I/O | PWMC0_PWMH0 | O | A19 | O | PWMC1_PWML2 | O | PIO,I,PU,ST
56 | L7 | N8 | VDDIO | GPIO_AD | PA24 | I/O | – | – | RTS1 | O | PWMC0_PWMH1 | O | A20 | O | ISI_PCK | I | PIO,I,PU,ST
59 | K8 | L8 | VDDIO | GPIO_AD | PA25 | I/O | – | – | CTS1 | I | PWMC0_PWMH2 | O | A23 | O | MCCK | O | PIO,I,PU,ST
62 | J8 | M9 | VDDIO | GPIO | PA26 | I/O | – | – | DCD1 | I | TIOA2 | O | MCDA2 | I/O | PWMC1_PWMFI1 | I | PIO,I,PU,ST
70 | J10 | N12 | VDDIO | GPIO_AD | PA27 | I/O | – | – | DTR1 | O | TIOB2 | I/O | MCDA3 | I/O | ISI_D7 | I | PIO,I,PU,ST
112 | C9 | C11 | VDDIO | GPIO | PA28 | I/O | – | – | DSR1 | I | TCLK1 | I | MCCDA | I/O | PWMC1_PWMFI2 | I | PIO,I,PU,ST
129 | A6 | A7 | VDDIO | GPIO | PA29 | I/O | – | – | RI1 | I | TCLK2 | I | – | – | – | – | PIO,I,PU,ST
116 | A10 | A11 | VDDIO | GPIO | PA30 | I/O | WKUP11(1) | I | PWMC0_PWML2 | O | PWMC1_PWMEXTRG0 | I | MCDA0 | I/O | I2SC0_DO | – | PIO,I,PU,ST
118 | C8 | C10 | VDDIO | GPIO_AD | PA31 | I/O | – | – | SPI0_NPCS1 | I/O | PCK2 | O | MCDA1 | I/O | PWMC1_PWMH2 | O | PIO,I,PU,ST
21 | H4 | H2 | VDDIO | GPIO | PB0 | I/O | AFE0_AD10/RTCOUT0(7) | I | PWMC0_PWMH0 | O | – | – | RXD0 | I | TF | I/O | PIO,I,PU,ST
20 | G3 | H1 | VDDIO | GPIO | PB1 | I/O | AFE1_AD0/RTCOUT1(7) | I | PWMC0_PWMH1 | O | GTSUCOMP | O | TXD0 | I/O | TK | I/O | PIO,I,PU,ST
26 | J2 | K1 | VDDIO | GPIO | PB2 | I/O | AFE0_AD5(5) | I | CANTX0 | O | – | – | CTS0 | I | SPI0_NPCS0 | I/O | PIO,I,PU,ST
31 | J3 | L1 | VDDIO | GPIO_AD | PB3 | I/O | AFE0_AD2/WKUP12(6) | I | CANRX0 | I | PCK2 | O | RTS0 | O | ISI_D2 | I | PIO,I,PU,ST
105 | A12 | C13 | VDDIO | GPIO_MLB | PB4 | I/O | TDI(9) | I | TWD1 | I/O | PWMC0_PWMH2 | O | – | – | TXD1 | I/O | PIO,I,PD,ST
109 | C10 | C12 | VDDIO | GPIO_MLB | PB5 | I/O | TDO/TRACESWO/WKUP13(9) | O | TWCK1 | O | PWMC0_PWML0 | O | – | – | TD | O | O,PU
79 | J11 | K11 | VDDIO | GPIO | PB6 | I/O | SWDIO/TMS(9) | I | – | – | – | – | – | – | – | – | PIO,I,ST
89 | F9 | H13 | VDDIO | GPIO | PB7 | I/O | SWCLK/TCK(9) | I | – | – | – | – | – | – | – | – | PIO,I,ST
141 | A3 | B2 | VDDIO | CLOCK | PB8 | I/O | XOUT(10) | O | – | – | – | – | – | – | – | – | PIO,HiZ
142 | A2 | A2 | VDDIO | CLOCK | PB9 | I/O | XIN(10) | I | – | – | – | – | – | – | – | – | PIO,HiZ
87 | G12 | J10 | VDDIO | GPIO | PB12 | I/O | ERASE(9) | I | PWMC0_PWML1 | O | GTSUCOMP | O | – | – | PCK0 | O | PIO,I,PD,ST
144 | B2 | A1 | VDDIO | GPIO_AD | PB13 | I/O | DAC0(11) | O | PWMC0_PWML2 | O | PCK0 | O | SCK0 | I/O | – | – | PIO,I,PU,ST
11 | E4 | F2 | VDDIO | GPIO_AD | PC0 | I/O | AFE1_AD9(5) | I | D0 | I/O | PWMC0_PWML0 | O | – | – | – | – | PIO,I,PU,ST
38 | J4 | M3 | VDDIO | GPIO_AD | PC1 | I/O | – | – | D1 | I/O | PWMC0_PWML1 | O | – | – | – | – | PIO,I,PU,ST
39 | K4 | N3 | VDDIO | GPIO_AD | PC2 | I/O | – | – | D2 | I/O | PWMC0_PWML2 | O | – | – | – | – | PIO,I,PU,ST
40 | L3 | N4 | VDDIO | GPIO_AD | PC3 | I/O | – | – | D3 | I/O | PWMC0_PWML3 | O | – | – | – | – | PIO,I,PU,ST
41 | J5 | L3 | VDDIO | GPIO_AD | PC4 | I/O | – | – | D4 | I/O | – | – | – | – | – | – | PIO,I,PU,ST
58 | L8 | M8 | VDDIO | GPIO_AD | PC5 | I/O | – | – | D5 | I/O | TIOA6 | I/O | – | – | – | – | PIO,I,PU,ST
54 | K7 | L7 | VDDIO | GPIO_AD | PC6 | I/O | – | – | D6 | I/O | TIOB6 | I/O | – | – | – | – | PIO,I,PU,ST
48 | M4 | L5 | VDDIO | GPIO_AD | PC7 | I/O | – | – | D7 | I/O | TCLK6 | I | – | – | – | – | PIO,I,PU,ST
82 | J12 | K13 | VDDIO | GPIO_AD | PC8 | I/O | – | – | NWR0/NWE | O | TIOA7 | I/O | – | – | – | – | PIO,I,PU,ST
86 | G11 | J11 | VDDIO | GPIO_AD | PC9 | I/O | – | – | NANDOE | O | TIOB7 | I/O | – | – | – | – | PIO,I,PU,ST
90 | F10 | H12 | VDDIO | GPIO_AD | PC10 | I/O | – | – | NANDWE | O | TCLK7 | I | – | – | – | – | PIO,I,PU,ST
94 | F11 | F13 | VDDIO | GPIO_AD | PC11 | I/O | – | – | NRD | O | TIOA8 | I/O | – | – | – | – | PIO,I,PU,ST
17 | F4 | G2 | VDDIO | GPIO_AD | PC12 | I/O | AFE1_AD3(5) | I | NCS3 | O | TIOB8 | I/O | CANRX1 | I | – | – | PIO,I,PU,ST
19 | G2 | H3 | VDDIO | GPIO_AD | PC13 | I/O | AFE1_AD1(5) | I | NWAIT | I | PWMC0_PWMH3 | O | SDA10 | O | – | – | PIO,I,PU,ST
97 | E10 | F12 | VDDIO | GPIO_AD | PC14 | I/O | – | – | NCS0 | O | TCLK8 | I | CANTX1 | O | – | – | PIO,I,PU,ST
18 | G1 | H4 | VDDIO | GPIO_AD | PC15 | I/O | AFE1_AD2(5) | I | NCS1/SDCS | O | PWMC0_PWML3 | O | – | – | – | – | PIO,I,PU,ST
100 | D11 | E12 | VDDIO | GPIO_AD | PC16 | I/O | – | – | A21/NANDALE | O | – | – | – | – | – | – | PIO,I,PU,ST
103 | B12 | E10 | VDDIO | GPIO_AD | PC17 | I/O | – | – | A22/NANDCLE | O | – | – | – | – | – | – | PIO,I,PU,ST
111 | B10 | B12 | VDDIO | GPIO_AD | PC18 | I/O | – | – | A0/NBS0 | O | PWMC0_PWML1 | O | – | – | – | – | PIO,I,PU,ST
117 | D8 | B10 | VDDIO | GPIO_AD | PC19 | I/O | – | – | A1 | O | PWMC0_PWMH2 | O | – | – | – | – | PIO,I,PU,ST
120 | A9 | C9 | VDDIO | GPIO_AD | PC20 | I/O | – | – | A2 | O | PWMC0_PWML2 | O | – | – | – | – | PIO,I,PU,ST
122 | A7 | A9 | VDDIO | GPIO_AD | PC21 | I/O | – | – | A3 | O | PWMC0_PWMH3 | O | – | – | – | – | PIO,I,PU,ST
124 | C7 | A8 | VDDIO | GPIO_AD | PC22 | I/O | – | – | A4 | O | PWMC0_PWML3 | O | – | – | – | – | PIO,I,PU,ST
127 | C6 | C7 | VDDIO | GPIO_AD | PC23 | I/O | – | – | A5 | O | TIOA3 | I/O | – | – | – | – | PIO,I,PU,ST
130 | B6 | D7 | VDDIO | GPIO_AD | PC24 | I/O | – | – | A6 | O | TIOB3 | I/O | SPI1_SPCK | O | – | – | PIO,I,PU,ST
133 | C5 | C6 | VDDIO | GPIO_AD | PC25 | I/O | – | – | A7 | O | TCLK3 | I | SPI1_NPCS0 | I/O | – | – | PIO,I,PU,ST
13 | F2 | F4 | VDDIO | GPIO_AD | PC26 | I/O | AFE1_AD7(5) | I | A8 | O | TIOA4 | I/O | SPI1_MISO | I | – | – | PIO,I,PU,ST
12 | E2 | F3 | VDDIO | GPIO_AD | PC27 | I/O | AFE1_AD8(5) | I | A9 | O | TIOB4 | I/O | SPI1_MOSI | O | – | – | PIO,I,PU,ST
76 | L12 | L13 | VDDIO | GPIO_AD | PC28 | I/O | – | – | A10 | O | TCLK4 | I | SPI1_NPCS1 | I/O | – | – | PIO,I,PU,ST
16 | F3 | G1 | VDDIO | GPIO_AD | PC29 | I/O | AFE1_AD4(5) | I | A11 | O | TIOA5 | I/O | SPI1_NPCS2 | O | – | – | PIO,I,PU,ST
15 | F1 | G3 | VDDIO | GPIO_AD | PC30 | I/O | AFE1_AD5(5) | I | A12 | O | TIOB5 | I/O | SPI1_NPCS3 | O | – | – | PIO,I,PU,ST
14 | E1 | G4 | VDDIO | GPIO_AD | PC31 | I/O | AFE1_AD6(5) | I | A13 | O | TCLK5 | I | – | – | – | – | PIO,I,PU,ST
1 | D4 | B1 | VDDIO | GPIO_AD | PD0 | I/O | DAC1(11) | I | GTXCK | I | PWMC1_PWML0 | O | SPI1_NPCS1 | I/O | DCD0 | I | PIO,I,PU,ST
132 | B5 | B6 | VDDIO | GPIO | PD1 | I/O | – | – | GTXEN | O | PWMC1_PWMH0 | O | SPI1_NPCS2 | I/O | DTR0 | O | PIO,I,PU,ST
131 | A5 | A6 | VDDIO | GPIO | PD2 | I/O | – | – | GTX0 | O | PWMC1_PWML1 | O | SPI1_NPCS3 | I/O | DSR0 | I | PIO,I,PU,ST
128 | B7 | B7 | VDDIO | GPIO | PD3 | I/O | – | – | GTX1 | O | PWMC1_PWMH1 | O | UTXD4 | O | RI0 | I | PIO,I,PU,ST
126 | D6 | C8 | VDDIO | GPIO_CLK | PD4 | I/O | – | – | GRXDV | I | PWMC1_PWML2 | O | TRACED0 | O | DCD2 | I | PIO,I,PU,ST
125 | D7 | B8 | VDDIO | GPIO_CLK | PD5 | I/O | – | – | GRX0 | I | PWMC1_PWMH2 | O | TRACED1 | O | DTR2 | O | PIO,I,PU,ST
121 | A8 | B9 | VDDIO | GPIO_CLK | PD6 | I/O | – | – | GRX1 | I | PWMC1_PWML3 | O | TRACED2 | O | DSR2 | I | PIO,I,PU,ST
119 | B8 | A10 | VDDIO | GPIO_CLK | PD7 | I/O | – | – | GRXER | I | PWMC1_PWMH3 | O | TRACED3 | O | RI2 | I | PIO,I,PU,ST
113 | E9 | A12 | VDDIO | GPIO_CLK | PD8 | I/O | – | – | GMDC | O | PWMC0_PWMFI1 | I | – | – | TRACECLK | O | PIO,I,PU,ST
110 | D9 | A13 | VDDIO | GPIO_CLK | PD9 | I/O | – | – | GMDIO | I/O | PWMC0_PWMFI2 | I | AFE1_ADTRG | I | – | – | PIO,I,PU,ST
101 | C12 | D13 | VDDIO | GPIO_MLB | PD10 | I/O | – | – | GCRS | I | PWMC0_PWML0 | O | TD | O | – | – | PIO,I,PD,ST
98 | E11 | E13 | VDDIO | GPIO_AD | PD11 | I/O | – | – | GRX2 | I | PWMC0_PWMH0 | O | GTSUCOMP | O | ISI_D5 | I | PIO,I,PU,ST
92 | G10 | G13 | VDDIO | GPIO_AD | PD12 | I/O | – | – | GRX3 | I | CANTX1 | O | SPI0_NPCS2 | O | ISI_D6 | I | PIO,I,PU,ST
88 | G9 | H11 | VDDIO | GPIO_CLK | PD13 | I/O | – | – | GCOL | I | – | – | SDA10 | O | – | – | PIO,I,PU,ST
84 | H10 | J12 | VDDIO | GPIO_AD | PD14 | I/O | – | – | GRXCK | I | – | – | SDCKE | O | – | – | PIO,I,PU,ST
106 | A11 | D11 | VDDIO | GPIO_AD | PD15 | I/O | – | – | GTX2 | O | RXD2 | I | NWR1/NBS1 | O | – | – | PIO,I,PU,ST
78 | K11 | K10 | VDDIO | GPIO_AD | PD16 | I/O | – | – | GTX3 | O | TXD2 | I/O | RAS | O | – | – | PIO,I,PU,ST
74 | L11 | M13 | VDDIO | GPIO_AD | PD17 | I/O | – | – | GTXER | O | SCK2 | I/O | CAS | O | – | – | PIO,I,PU,ST
69 | M10 | M11 | VDDIO | GPIO_AD | PD18 | I/O | – | – | NCS1/SDCS | O | RTS2 | O | URXD4 | I | – | – | PIO,I,PU,ST
67 | M9 | L10 | VDDIO | GPIO_AD | PD19 | I/O | – | – | NCS3 | O | CTS2 | I | UTXD4 | O | – | – | PIO,I,PU,ST
65 | K9 | K9 | VDDIO | GPIO | PD20 | I/O | – | – | PWMC0_PWMH0 | O | SPI0_MISO | I/O | GTSUCOMP | O | – | – | PIO,I,PU,ST
63 | H9 | L9 | VDDIO | GPIO_AD | PD21 | I/O | – | – | PWMC0_PWMH1 | O | SPI0_MOSI | I/O | TIOA11 | I/O | ISI_D1 | I | PIO,I,PU,ST
60 | M8 | N9 | VDDIO | GPIO_AD | PD22 | I/O | – | – | PWMC0_PWMH2 | O | SPI0_SPCK | O | TIOB11 | I/O | ISI_D0 | I | PIO,I,PU,ST
57 | M7 | N7 | VDDIO | GPIO_CLK | PD23 | I/O | – | – | PWMC0_PWMH3 | O | – | – | SDCK | O | – | – | PIO,I,PU,ST
55 | M6 | K7 | VDDIO | GPIO_AD | PD24 | I/O | – | – | PWMC0_PWML0 | O | RF | I/O | TCLK11 | I | ISI_HSYNC | I | PIO,I,PU,ST
52 | M5 | L6 | VDDIO | GPIO_AD | PD25 | I/O | – | – | PWMC0_PWML1 | O | SPI0_NPCS1 | I/O | URXD2 | I | ISI_VSYNC | I | PIO,I,PU,ST
53 | L6 | M7 | VDDIO | GPIO | PD26 | I/O | – | – | PWMC0_PWML2 | O | TD | O | UTXD2 | O | UTXD1 | O | PIO,I,PU,ST
47 | J6 | M5 | VDDIO | GPIO_AD | PD27 | I/O | – | – | PWMC0_PWML3 | O | SPI0_NPCS3 | O | TWD2 | O | ISI_D8 | I | PIO,I,PU,ST
71 | K10 | M12 | VDDIO | GPIO_AD | PD28 | I/O | WKUP5(1) | I | URXD3 | I | CANRX1 | I | TWCK2 | O | ISI_D9 | I | PIO,I,PU,ST
108 | D10 | B13 | VDDIO | GPIO_AD | PD29 | I/O | – | – | – | – | – | – | SDWE | O | – | – | PIO,I,PU,ST
34 | M1 | L2 | VDDIO | GPIO_AD | PD30 | I/O | AFE0_AD0(5) | I | UTXD3 | 0 | – | – | – | – | ISI_D10 | I | PIO,I,PU,ST
2 | D3 | C3 | VDDIO | GPIO_AD | PD31 | I/O | – | – | QIO3 | I/O | UTXD3 | O | PCK2 | O | ISI_D11 | I | PIO,I,PU,ST
4 | C2 | C2 | VDDIO | GPIO_AD | PE0 | I/O | AFE1_AD11(5) | I | D8 | I/O | TIOA9 | I/O | I2SC1_WS | – | – | – | PIO,I,PU,ST
6 | A1 | D2 | VDDIO | GPIO_AD | PE1 | I/O | – | – | D9 | I/O | TIOB9 | I/O | I2SC1_DO | – | – | – | PIO,I,PU,ST
7 | B1 | D1 | VDDIO | GPIO_AD | PE2 | I/O | – | – | D10 | I/O | TCLK9 | I | I2SC1_DI | – | – | – | PIO,I,PU,ST
10 | E3 | F1 | VDDIO | GPIO_AD | PE3 | I/O | AFE1_AD10(5) | I | D11 | I/O | TIOA10 | I/O | – | – | – | – | PIO,I,PU,ST
27 | K1 | K2 | VDDIO | GPIO_AD | PE4 | I/O | AFE0_AD4(5) | I | D12 | I/O | TIOB10 | I/O | – | – | – | – | PIO,I,PU,ST
28 | L1 | K3 | VDDIO | GPIO_AD | PE5 | I/O | AFE0_AD3(5) | I | D13 | I/O | TCLK10 | I/O | – | – | – | – | PIO,I,PU,ST
3 | C3 | E4 | VDDOUT | Power | VDDOUT | – | – | – | – | – | – | – | – | – | – | – | –
5 | C1 | C1 | VDDIN | Power | VDDIN | – | – | – | – | – | – | – | – | – | – | – | –
8 | D2 | E2 | GND | Reference | VREFN | I | – | – | – | – | – | – | – | – | – | – | –
9 | D1 | E1 | VDDIO | Reference | VREFP | I | – | – | – | – | – | – | – | – | – | – | –
83 | H12 | K12 | VDDIO | RST | NRST | I/O | – | – | – | – | – | – | – | – | – | – | I,PU
85 | H11 | J13 | VDDIO | TEST | TST | I | – | – | – | – | – | – | – | – | – | – | I,PD
30,43,72, 80,96 | G8,H6,H7 | D6,F10,K6 | VDDIO | Power | VDDIO | – | – | – | – | – | – | – | – | – | – | – | –
104 | B11 | D12 | VDDIO | TEST | JTAGSEL | I | – | – | – | – | – | – | – | – | – | – | I,PD
29,33,50, 81,107 | E8,H5,H8 | D5,G10,K5 | VDDCORE | Power | VDDCORE | – | – | – | – | – | – | – | – | – | – | – | –
123 | J7 | D8 | VDDPLL | Power | VDDPLL | – | – | – | – | – | – | – | – | – | – | – | –
134 | E7 | B4 | VDDUTMII | Power | VDDUTMII | – | – | – | – | – | – | – | – | – | – | – | –
136 | B4 | A5 | VDDUTMII | USBHS | HSDM | I/O | – | – | – | – | – | – | – | – | – | – | –
137 | A4 | A4 | VDDUTMII | USBHS | HSDP | I/O | – | – | – | – | – | – | – | – | – | – | –
44,61,95, 115,135,138 | F5,F6,G4, G5,G6,G7 | C5,D3,D10, H10,K4,K8 | GND | Ground | GND | – | – | – | – | – | – | – | – | – | – | – | –
– | D5 | E3 | GNDANA | Ground | GNDANA | – | – | – | – | – | – | – | – | – | – | – | –
– | E5 | B5 | GNDUTMI | Ground | GNDUTMI | – | – | – | – | – | – | – | – | – | – | – | –
– | E6 | B3 | GNDPLLUSB | Ground | GNDPLLUSB | – | – | – | – | – | – | – | – | – | – | – | –
– | F7 | D9 | GNDPLL | Ground | GNDPLL | – | – | – | – | – | – | – | – | – | – | – | –
139 | B3 | C4 | VDDUTMIC | Power | VDDUTMIC | – | – | – | – | – | – | – | – | – | – | – | –
140 | C4 | A3 | – | VBG | VBG | I | – | – | – | – | – | – | – | – | – | – | –
143 | F8 | D4 | VDDPLLUSB | Power | VDDPLLUSB | – | – | – | – | – | – | – | – | – | – | – | –
LQFP Pin | LFBGA Ball | UFBGA Ball | Power Rail | I/O Type | Primary |  | Alternate |  | PIO Peripheral A |  | PIO Peripheral B |  | PIO Peripheral C |  | PIO Peripheral D |  | Reset State
 |  |  |  |  | Signal | Dir | Signal | Dir | Signal | Dir | Signal | Dir | Signal | Dir | Signal | Dir | Signal, Dir, PU, PD, HiZ, ST
1 | D4 | B1 | VDDIO | GPIO_AD | PD0 | I/O | DAC1(11) | I | GTXCK | I | PWMC1_PWML0 | O | SPI1_NPCS1 | I/O | DCD0 | I | PIO,I,PU,ST
2 | D3 | C3 | VDDIO | GPIO_AD | PD31 | I/O | – | – | QIO3 | I/O | UTXD3 | O | PCK2 | O | ISI_D11 | I | PIO,I,PU,ST
3 | C3 | E4 | VDDOUT | Power | VDDOUT | – | – | – | – | – | – | – | – | – | – | – | –
4 | C2 | C2 | VDDIO | GPIO_AD | PE0 | I/O | AFE1_AD11(5) | I | D8 | I/O | TIOA9 | I/O | I2SC1_WS | – | – | – | PIO,I,PU,ST
5 | C1 | C1 | VDDIN | Power | VDDIN | – | – | – | – | – | – | – | – | – | – | – | –
6 | A1 | D2 | VDDIO | GPIO_AD | PE1 | I/O | – | – | D9 | I/O | TIOB9 | I/O | I2SC1_DO | – | – | – | PIO,I,PU,ST
7 | B1 | D1 | VDDIO | GPIO_AD | PE2 | I/O | – | – | D10 | I/O | TCLK9 | I | I2SC1_DI | – | – | – | PIO,I,PU,ST
8 | D2 | E2 | GND | Reference | VREFN | I | – | – | – | – | – | – | – | – | – | – | –
9 | D1 | E1 | VDDIO | Reference | VREFP | I | – | – | – | – | – | – | – | – | – | – | –
10 | E3 | F1 | VDDIO | GPIO_AD | PE3 | I/O | AFE1_AD10(5) | I | D11 | I/O | TIOA10 | I/O | – | – | – | – | PIO,I,PU,ST
11 | E4 | F2 | VDDIO | GPIO_AD | PC0 | I/O | AFE1_AD9(5) | I | D0 | I/O | PWMC0_PWML0 | O | – | – | – | – | PIO,I,PU,ST
12 | E2 | F3 | VDDIO | GPIO_AD | PC27 | I/O | AFE1_AD8(5) | I | A9 | O | TIOB4 | I/O | SPI1_MOSI | O | – | – | PIO,I,PU,ST
13 | F2 | F4 | VDDIO | GPIO_AD | PC26 | I/O | AFE1_AD7(5) | I | A8 | O | TIOA4 | I/O | SPI1_MISO | I | – | – | PIO,I,PU,ST
14 | E1 | G4 | VDDIO | GPIO_AD | PC31 | I/O | AFE1_AD6(5) | I | A13 | O | TCLK5 | I | – | – | – | – | PIO,I,PU,ST
15 | F1 | G3 | VDDIO | GPIO_AD | PC30 | I/O | AFE1_AD5(5) | I | A12 | O | TIOB5 | I/O | SPI1_NPCS3 | O | – | – | PIO,I,PU,ST
16 | F3 | G1 | VDDIO | GPIO_AD | PC29 | I/O | AFE1_AD4(5) | I | A11 | O | TIOA5 | I/O | SPI1_NPCS2 | O | – | – | PIO,I,PU,ST
17 | F4 | G2 | VDDIO | GPIO_AD | PC12 | I/O | AFE1_AD3(5) | I | NCS3 | O | TIOB8 | I/O | CANRX1 | I | – | – | PIO,I,PU,ST
18 | G1 | H4 | VDDIO | GPIO_AD | PC15 | I/O | AFE1_AD2(5) | I | NCS1/SDCS | O | PWMC0_PWML3 | O | – | – | – | – | PIO,I,PU,ST
19 | G2 | H3 | VDDIO | GPIO_AD | PC13 | I/O | AFE1_AD1(5) | I | NWAIT | I | PWMC0_PWMH3 | O | SDA10 | O | – | – | PIO,I,PU,ST
20 | G3 | H1 | VDDIO | GPIO | PB1 | I/O | AFE1_AD0/RTCOUT1(7) | I | PWMC0_PWMH1 | O | GTSUCOMP | O | TXD0 | I/O | TK | I/O | PIO,I,PU,ST
21 | H4 | H2 | VDDIO | GPIO | PB0 | I/O | AFE0_AD10/RTCOUT0(7) | I | PWMC0_PWMH0 | O | – | – | RXD0 | I | TF | I/O | PIO,I,PU,ST
22 | H3 | J1 | VDDIO | GPIO_AD | PA20 | I/O | AFE0_AD9/WKUP10(6) | I | – | – | PWMC0_PWML1 | O | A16/BA0 | O | I2SC1_CK | – | PIO,I,PU,ST
23 | H1 | J2 | VDDIO | GPIO_AD | PA19 | I/O | AFE0_AD8/WKUP9(6) | I | – | – | PWMC0_PWML0 | O | A15 | O | I2SC1_MCK | – | PIO,I,PU,ST
24 | H2 | J3 | VDDIO | GPIO_AD | PA18 | I/O | AFE0_AD7(5) | I | PWMC1_PWMEXTRG1 | I | PCK2 | O | A14 | O | – | – | PIO,I,PU,ST
25 | J1 | J4 | VDDIO | GPIO_AD | PA17 | I/O | AFE0_AD6(5) | I | QIO2 | I/O | PCK1 | O | PWMC0_PWMH3 | O | – | – | PIO,I,PU,ST
26 | J2 | K1 | VDDIO | GPIO | PB2 | I/O | AFE0_AD5(5) | I | CANTX0 | O | – | – | CTS0 | I | SPI0_NPCS0 | I/O | PIO,I,PU,ST
27 | K1 | K2 | VDDIO | GPIO_AD | PE4 | I/O | AFE0_AD4(5) | I | D12 | I/O | TIOB10 | I/O | – | – | – | – | PIO,I,PU,ST
28 | L1 | K3 | VDDIO | GPIO_AD | PE5 | I/O | AFE0_AD3(5) | I | D13 | I/O | TCLK10 | I/O | – | – | – | – | PIO,I,PU,ST
31 | J3 | L1 | VDDIO | GPIO_AD | PB3 | I/O | AFE0_AD2/WKUP12(6) | I | CANRX0 | I | PCK2 | O | RTS0 | O | ISI_D2 | I | PIO,I,PU,ST
32 | K2 | M1 | VDDIO | GPIO_AD | PA21 | I/O | AFE0_AD1/PIODCEN2(8) | I | RXD1 | I | PCK1 | O | PWMC1_PWMFI0 | I | – | – | PIO,I,PU,ST
34 | M1 | L2 | VDDIO | GPIO_AD | PD30 | I/O | AFE0_AD0(5) | I | UTXD3 | 0 | – | – | – | – | ISI_D10 | I | PIO,I,PU,ST
35 | L2 | N1 | VDDIO | CLOCK | PA7 | I/O | XIN32(4) | I | – | – | PWMC0_PWMH3 | O | – | – | – | – | PIO,HiZ
36 | M2 | N2 | VDDIO | CLOCK | PA8 | I/O | XOUT32(4) | O | PWMC1_PWMH3 | O | AFE0_ADTRG | I | – | – | – | – | PIO,HiZ
37 | K3 | M2 | VDDIO | GPIO_AD | PA22 | I/O | PIODCCLK(2) | I | RK | I/O | PWMC0_PWMEXTRG1 | I | NCS2 | O | – | – | PIO,I,PU,ST
38 | J4 | M3 | VDDIO | GPIO_AD | PC1 | I/O | – | – | D1 | I/O | PWMC0_PWML1 | O | – | – | – | – | PIO,I,PU,ST
39 | K4 | N3 | VDDIO | GPIO_AD | PC2 | I/O | – | – | D2 | I/O | PWMC0_PWML2 | O | – | – | – | – | PIO,I,PU,ST
40 | L3 | N4 | VDDIO | GPIO_AD | PC3 | I/O | – | – | D3 | I/O | PWMC0_PWML3 | O | – | – | – | – | PIO,I,PU,ST
41 | J5 | L3 | VDDIO | GPIO_AD | PC4 | I/O | – | – | D4 | I/O | – | – | – | – | – | – | PIO,I,PU,ST
42 | M3 | M4 | VDDIO | GPIO_AD | PA13 | I/O | PIODC7(2) | I | QIO0 | I/O | PWMC0_PWMH2 | O | PWMC1_PWML1 | O | – | – | PIO,I,PU,ST
45 | K5 | L4 | VDDIO | GPIO_AD | PA16 | I/O | – | – | D15 | I/O | TIOB1 | I/O | PWMC0_PWML2 | O | I2SC0_DI | – | PIO,I,PU,ST
46 | L4 | N5 | VDDIO | GPIO_AD | PA23 | I/O | – | – | SCK1 | I/O | PWMC0_PWMH0 | O | A19 | O | PWMC1_PWML2 | O | PIO,I,PU,ST
47 | J6 | M5 | VDDIO | GPIO_AD | PD27 | I/O | – | – | PWMC0_PWML3 | O | SPI0_NPCS3 | O | TWD2 | O | ISI_D8 | I | PIO,I,PU,ST
48 | M4 | L5 | VDDIO | GPIO_AD | PC7 | I/O | – | – | D7 | I/O | TCLK6 | I | – | – | – | – | PIO,I,PU,ST
49 | L5 | N6 | VDDIO | GPIO_AD | PA15 | I/O | – | – | D14 | I/O | TIOA1 | I/O | PWMC0_PWML3 | O | I2SC0_WS | – | PIO,I,PU,ST
51 | K6 | M6 | VDDIO | GPIO_CLK | PA14 | I/O | WKUP8/PIODCEN1(3) | I | QSCK | O | PWMC0_PWMH3 | O | PWMC1_PWMH1 | O | – | – | PIO,I,PU,ST
52 | M5 | L6 | VDDIO | GPIO_AD | PD25 | I/O | – | – | PWMC0_PWML1 | O | SPI0_NPCS1 | I/O | URXD2 | I | ISI_VSYNC | I | PIO,I,PU,ST
53 | L6 | M7 | VDDIO | GPIO | PD26 | I/O | – | – | PWMC0_PWML2 | O | TD | O | UTXD2 | O | UTXD1 | O | PIO,I,PU,ST
54 | K7 | L7 | VDDIO | GPIO_AD | PC6 | I/O | – | – | D6 | I/O | TIOB6 | I/O | – | – | – | – | PIO,I,PU,ST
55 | M6 | K7 | VDDIO | GPIO_AD | PD24 | I/O | – | – | PWMC0_PWML0 | O | RF | I/O | TCLK11 | I | ISI_HSYNC | I | PIO,I,PU,ST
56 | L7 | N8 | VDDIO | GPIO_AD | PA24 | I/O | – | – | RTS1 | O | PWMC0_PWMH1 | O | A20 | O | ISI_PCK | I | PIO,I,PU,ST
57 | M7 | N7 | VDDIO | GPIO_CLK | PD23 | I/O | – | – | PWMC0_PWMH3 | O | – | – | SDCK | O | – | – | PIO,I,PU,ST
58 | L8 | M8 | VDDIO | GPIO_AD | PC5 | I/O | – | – | D5 | I/O | TIOA6 | I/O | – | – | – | – | PIO,I,PU,ST
59 | K8 | L8 | VDDIO | GPIO_AD | PA25 | I/O | – | – | CTS1 | I | PWMC0_PWMH2 | O | A23 | O | MCCK | O | PIO,I,PU,ST
60 | M8 | N9 | VDDIO | GPIO_AD | PD22 | I/O | – | – | PWMC0_PWMH2 | O | SPI0_SPCK | O | TIOB11 | I/O | ISI_D0 | I | PIO,I,PU,ST
62 | J8 | M9 | VDDIO | GPIO | PA26 | I/O | – | – | DCD1 | I | TIOA2 | O | MCDA2 | I/O | PWMC1_PWMFI1 | I | PIO,I,PU,ST
63 | H9 | L9 | VDDIO | GPIO_AD | PD21 | I/O | – | – | PWMC0_PWMH1 | O | SPI0_MOSI | I/O | TIOA11 | I/O | ISI_D1 | I | PIO,I,PU,ST
64 | J9 | N10 | VDDIO | GPIO_AD | PA11 | I/O | WKUP7/PIODC5(3) | I | QCS | O | PWMC0_PWMH0 | O | PWMC1_PWML0 | O | – | – | PIO,I,PU,ST
65 | K9 | K9 | VDDIO | GPIO | PD20 | I/O | – | – | PWMC0_PWMH0 | O | SPI0_MISO | I/O | GTSUCOMP | O | – | – | PIO,I,PU,ST
66 | L9 | M10 | VDDIO | GPIO_AD | PA10 | I/O | PIODC4(2) | I | UTXD0 | O | PWMC0_PWMEXTRG0 | I | RD | I | – | – | PIO,I,PU,ST
67 | M9 | L10 | VDDIO | GPIO_AD | PD19 | I/O | – | – | NCS3 | O | CTS2 | I | UTXD4 | O | – | – | PIO,I,PU,ST
68 | L10 | N11 | VDDIO | GPIO_AD | PA12 | I/O | PIODC6(2) | I | QIO1 | I/O | PWMC0_PWMH1 | O | PWMC1_PWMH0 | O | – | – | PIO,I,PU,ST
69 | M10 | M11 | VDDIO | GPIO_AD | PD18 | I/O | – | – | NCS1/SDCS | O | RTS2 | O | URXD4 | I | – | – | PIO,I,PU,ST
70 | J10 | N12 | VDDIO | GPIO_AD | PA27 | I/O | – | – | DTR1 | O | TIOB2 | I/O | MCDA3 | I/O | ISI_D7 | I | PIO,I,PU,ST
71 | K10 | M12 | VDDIO | GPIO_AD | PD28 | I/O | WKUP5(1) | I | URXD3 | I | CANRX1 | I | TWCK2 | O | ISI_D9 | I | PIO,I,PU,ST
73 | M11 | N13 | VDDIO | GPIO_AD | PA5 | I/O | WKUP4/PIODC2(3) | I | PWMC1_PWML3 | O | ISI_D4 | I | URXD1 | I | – | – | PIO,I,PU,ST
74 | L11 | M13 | VDDIO | GPIO_AD | PD17 | I/O | – | – | GTXER | O | SCK2 | I/O | CAS | O | – | – | PIO,I,PU,ST
75 | M12 | L11 | VDDIO | GPIO_AD | PA9 | I/O | WKUP6/PIODC3(3) | I | URXD0 | I | ISI_D3 | I | PWMC0_PWMFI0 | I | – | – | PIO,I,PU,ST
76 | L12 | L13 | VDDIO | GPIO_AD | PC28 | I/O | – | – | A10 | O | TCLK4 | I | SPI1_NPCS1 | I/O | – | – | PIO,I,PU,ST
77 | K12 | L12 | VDDIO | GPIO | PA4 | I/O | WKUP3/PIODC1(3) | I | TWCK0 | O | TCLK0 | I | UTXD1 | O | – | – | PIO,I,PU,ST
78 | K11 | K10 | VDDIO | GPIO_AD | PD16 | I/O | – | – | GTX3 | O | TXD2 | I/O | RAS | O | – | – | PIO,I,PU,ST
79 | J11 | K11 | VDDIO | GPIO | PB6 | I/O | SWDIO/TMS(9) | I | – | – | – | – | – | – | – | – | PIO,I,ST
82 | J12 | K13 | VDDIO | GPIO_AD | PC8 | I/O | – | – | NWR0/NWE | O | TIOA7 | I/O | – | – | – | – | PIO,I,PU,ST
83 | H12 | K12 | VDDIO | RST | NRST | I/O | – | – | – | – | – | – | – | – | – | – | I,PU
84 | H10 | J12 | VDDIO | GPIO_AD | PD14 | I/O | – | – | GRXCK | I | – | – | SDCKE | O | – | – | PIO,I,PU,ST
85 | H11 | J13 | VDDIO | TEST | TST | I | – | – | – | – | – | – | – | – | – | – | I,PD
86 | G11 | J11 | VDDIO | GPIO_AD | PC9 | I/O | – | – | NANDOE | O | TIOB7 | I/O | – | – | – | – | PIO,I,PU,ST
87 | G12 | J10 | VDDIO | GPIO | PB12 | I/O | ERASE(9) | I | PWMC0_PWML1 | O | GTSUCOMP | O | – | – | PCK0 | O | PIO,I,PD,ST
88 | G9 | H11 | VDDIO | GPIO_CLK | PD13 | I/O | – | – | GCOL | I | – | – | SDA10 | O | – | – | PIO,I,PU,ST
89 | F9 | H13 | VDDIO | GPIO | PB7 | I/O | SWCLK/TCK(9) | I | – | – | – | – | – | – | – | – | PIO,I,ST
90 | F10 | H12 | VDDIO | GPIO_AD | PC10 | I/O | – | – | NANDWE | O | TCLK7 | I | – | – | – | – | PIO,I,PU,ST
91 | F12 | G11 | VDDIO | GPIO_AD | PA3 | I/O | PIODC0(2) | I | TWD0 | I/O | LONCOL1 | I | PCK2 | O | – | – | PIO,I,PU,ST
92 | G10 | G13 | VDDIO | GPIO_AD | PD12 | I/O | – | – | GRX3 | I | CANTX1 | O | SPI0_NPCS2 | O | ISI_D6 | I | PIO,I,PU,ST
93 | E12 | G12 | VDDIO | GPIO | PA2 | I/O | WKUP2(1) | I | PWMC0_PWMH1 | O | – | – | DATRG | I | – | – | PIO,I,PU,ST
94 | F11 | F13 | VDDIO | GPIO_AD | PC11 | I/O | – | – | NRD | O | TIOA8 | I/O | – | – | – | – | PIO,I,PU,ST
97 | E10 | F12 | VDDIO | GPIO_AD | PC14 | I/O | – | – | NCS0 | O | TCLK8 | I | CANTX1 | O | – | – | PIO,I,PU,ST
98 | E11 | E13 | VDDIO | GPIO_AD | PD11 | I/O | – | – | GRX2 | I | PWMC0_PWMH0 | O | GTSUCOMP | O | ISI_D5 | I | PIO,I,PU,ST
99 | D12 | F11 | VDDIO | GPIO_AD | PA1 | I/O | WKUP1(1) | I | PWMC0_PWML0 | O | TIOB0 | I/O | A18 | O | I2SC0_CK | – | PIO,I,PU,ST
100 | D11 | E12 | VDDIO | GPIO_AD | PC16 | I/O | – | – | A21/NANDALE | O | – | – | – | – | – | – | PIO,I,PU,ST
101 | C12 | D13 | VDDIO | GPIO_MLB | PD10 | I/O | – | – | GCRS | I | PWMC0_PWML0 | O | TD | O | – | – | PIO,I,PD,ST
102 | C11 | E11 | VDDIO | GPIO_AD | PA0 | I/O | WKUP0(1) | I | PWMC0_PWMH0 | O | TIOA0 | I/O | A17/BA1 | O | I2SC0_MCK | – | PIO,I,PU,ST
103 | B12 | E10 | VDDIO | GPIO_AD | PC17 | I/O | – | – | A22/NANDCLE | O | – | – | – | – | – | – | PIO,I,PU,ST
104 | B11 | D12 | VDDIO | TEST | JTAGSEL | I | – | – | – | – | – | – | – | – | – | – | I,PD
105 | A12 | C13 | VDDIO | GPIO_MLB | PB4 | I/O | TDI(9) | I | TWD1 | I/O | PWMC0_PWMH2 | O | – | – | TXD1 | I/O | PIO,I,PD,ST
106 | A11 | D11 | VDDIO | GPIO_AD | PD15 | I/O | – | – | GTX2 | O | RXD2 | I | NWR1/NBS1 | O | – | – | PIO,I,PU,ST
108 | D10 | B13 | VDDIO | GPIO_AD | PD29 | I/O | – | – | – | – | – | – | SDWE | O | – | – | PIO,I,PU,ST
109 | C10 | C12 | VDDIO | GPIO_MLB | PB5 | I/O | TDO/TRACESWO/WKUP13(9) | O | TWCK1 | O | PWMC0_PWML0 | O | – | – | TD | O | O,PU
110 | D9 | A13 | VDDIO | GPIO_CLK | PD9 | I/O | – | – | GMDIO | I/O | PWMC0_PWMFI2 | I | AFE1_ADTRG | I | – | – | PIO,I,PU,ST
111 | B10 | B12 | VDDIO | GPIO_AD | PC18 | I/O | – | – | A0/NBS0 | O | PWMC0_PWML1 | O | – | – | – | – | PIO,I,PU,ST
112 | C9 | C11 | VDDIO | GPIO | PA28 | I/O | – | – | DSR1 | I | TCLK1 | I | MCCDA | I/O | PWMC1_PWMFI2 | I | PIO,I,PU,ST
113 | E9 | A12 | VDDIO | GPIO_CLK | PD8 | I/O | – | – | GMDC | O | PWMC0_PWMFI1 | I | – | – | TRACECLK | O | PIO,I,PU,ST
114 | B9 | B11 | VDDIO | GPIO_AD | PA6 | I/O | – | – | – | – | PCK0 | O | UTXD1 | O | – | – | PIO,I,PU,ST
116 | A10 | A11 | VDDIO | GPIO | PA30 | I/O | WKUP11(1) | I | PWMC0_PWML2 | O | PWMC1_PWMEXTRG0 | I | MCDA0 | I/O | I2SC0_DO | – | PIO,I,PU,ST
117 | D8 | B10 | VDDIO | GPIO_AD | PC19 | I/O | – | – | A1 | O | PWMC0_PWMH2 | O | – | – | – | – | PIO,I,PU,ST
118 | C8 | C10 | VDDIO | GPIO_AD | PA31 | I/O | – | – | SPI0_NPCS1 | I/O | PCK2 | O | MCDA1 | I/O | PWMC1_PWMH2 | O | PIO,I,PU,ST
119 | B8 | A10 | VDDIO | GPIO_CLK | PD7 | I/O | – | – | GRXER | I | PWMC1_PWMH3 | O | TRACED3 | O | RI2 | I | PIO,I,PU,ST
120 | A9 | C9 | VDDIO | GPIO_AD | PC20 | I/O | – | – | A2 | O | PWMC0_PWML2 | O | – | – | – | – | PIO,I,PU,ST
121 | A8 | B9 | VDDIO | GPIO_CLK | PD6 | I/O | – | – | GRX1 | I | PWMC1_PWML3 | O | TRACED2 | O | DSR2 | I | PIO,I,PU,ST
122 | A7 | A9 | VDDIO | GPIO_AD | PC21 | I/O | – | – | A3 | O | PWMC0_PWMH3 | O | – | – | – | – | PIO,I,PU,ST
123 | J7 | D8 | VDDPLL | Power | VDDPLL | – | – | – | – | – | – | – | – | – | – | – | –
124 | C7 | A8 | VDDIO | GPIO_AD | PC22 | I/O | – | – | A4 | O | PWMC0_PWML3 | O | – | – | – | – | PIO,I,PU,ST
125 | D7 | B8 | VDDIO | GPIO_CLK | PD5 | I/O | – | – | GRX0 | I | PWMC1_PWMH2 | O | TRACED1 | O | DTR2 | O | PIO,I,PU,ST
126 | D6 | C8 | VDDIO | GPIO_CLK | PD4 | I/O | – | – | GRXDV | I | PWMC1_PWML2 | O | TRACED0 | O | DCD2 | I | PIO,I,PU,ST
127 | C6 | C7 | VDDIO | GPIO_AD | PC23 | I/O | – | – | A5 | O | TIOA3 | I/O | – | – | – | – | PIO,I,PU,ST
128 | B7 | B7 | VDDIO | GPIO | PD3 | I/O | – | – | GTX1 | O | PWMC1_PWMH1 | O | UTXD4 | O | RI0 | I | PIO,I,PU,ST
129 | A6 | A7 | VDDIO | GPIO | PA29 | I/O | – | – | RI1 | I | TCLK2 | I | – | – | – | – | PIO,I,PU,ST
130 | B6 | D7 | VDDIO | GPIO_AD | PC24 | I/O | – | – | A6 | O | TIOB3 | I/O | SPI1_SPCK | O | – | – | PIO,I,PU,ST
131 | A5 | A6 | VDDIO | GPIO | PD2 | I/O | – | – | GTX0 | O | PWMC1_PWML1 | O | SPI1_NPCS3 | I/O | DSR0 | I | PIO,I,PU,ST
132 | B5 | B6 | VDDIO | GPIO | PD1 | I/O | – | – | GTXEN | O | PWMC1_PWMH0 | O | SPI1_NPCS2 | I/O | DTR0 | O | PIO,I,PU,ST
133 | C5 | C6 | VDDIO | GPIO_AD | PC25 | I/O | – | – | A7 | O | TCLK3 | I | SPI1_NPCS0 | I/O | – | – | PIO,I,PU,ST
134 | E7 | B4 | VDDUTMII | Power | VDDUTMII | – | – | – | – | – | – | – | – | – | – | – | –
136 | B4 | A5 | VDDUTMII | USBHS | HSDM | I/O | – | – | – | – | – | – | – | – | – | – | –
137 | A4 | A4 | VDDUTMII | USBHS | HSDP | I/O | – | – | – | – | – | – | – | – | – | – | –
139 | B3 | C4 | VDDUTMIC | Power | VDDUTMIC | – | – | – | – | – | – | – | – | – | – | – | –
140 | C4 | A3 | – | VBG | VBG | I | – | – | – | – | – | – | – | – | – | – | –
141 | A3 | B2 | VDDIO | CLOCK | PB8 | I/O | XOUT(10) | O | – | – | – | – | – | – | – | – | PIO,HiZ
142 | A2 | A2 | VDDIO | CLOCK | PB9 | I/O | XIN(10) | I | – | – | – | – | – | – | – | – | PIO,HiZ
143 | F8 | D4 | VDDPLLUSB | Power | VDDPLLUSB | – | – | – | – | – | – | – | – | – | – | – | –
144 | B2 | A1 | VDDIO | GPIO_AD | PB13 | I/O | DAC0(11) | O | PWMC0_PWML2 | O | PCK0 | O | SCK0 | I/O | – | – | PIO,I,PU,ST
– | D5 | E3 | GNDANA | Ground | GNDANA | – | – | – | – | – | – | – | – | – | – | – | –
– | F7 | D9 | GNDPLL | Ground | GNDPLL | – | – | – | – | – | – | – | – | – | – | – | –
– | E6 | B3 | GNDPLLUSB | Ground | GNDPLLUSB | – | – | – | – | – | – | – | – | – | – | – | –
– | E5 | B5 | GNDUTMI | Ground | GNDUTMI | – | – | – | – | – | – | – | – | – | – | – | –
29,33,50, 81,107 | E8,H5,H8 | D5,G10,K5 | VDDCORE | Power | VDDCORE | – | – | – | – | – | – | – | – | – | – | – | –
30,43,72, 80,96 | G8,H6,H7 | D6,F10,K6 | VDDIO | Power | VDDIO | – | – | – | – | – | – | – | – | – | – | – | –
44,61,95, 115,135,138 | F5,F6,G4, G5,G6,G7 | C5,D3,D10, H10,K4,K8 | GND | Ground | GND | – | – | – | – | – | – | – | – | – | – | – | –

Sheet: Port pins
LQFP Pin | Primary
 | Signal
102 | PA0
99 | PA1
93 | PA2
91 | PA3
77 | PA4
73 | PA5
114 | PA6
35 | PA7
36 | PA8
75 | PA9
66 | PA10
64 | PA11
68 | PA12
42 | PA13
51 | PA14
49 | PA15
45 | PA16
25 | PA17
24 | PA18
23 | PA19
22 | PA20
32 | PA21
37 | PA22
46 | PA23
56 | PA24
59 | PA25
62 | PA26
70 | PA27
112 | PA28
129 | PA29
116 | PA30
118 | PA31
21 | PB0
20 | PB1
26 | PB2
31 | PB3
105 | PB4
109 | PB5
79 | PB6
89 | PB7
141 | PB8
142 | PB9
87 | PB12
144 | PB13
11 | PC0
38 | PC1
39 | PC2
40 | PC3
41 | PC4
58 | PC5
54 | PC6
48 | PC7
82 | PC8
86 | PC9
90 | PC10
94 | PC11
17 | PC12
19 | PC13
97 | PC14
18 | PC15
100 | PC16
103 | PC17
111 | PC18
117 | PC19
120 | PC20
122 | PC21
124 | PC22
127 | PC23
130 | PC24
133 | PC25
13 | PC26
12 | PC27
76 | PC28
16 | PC29
15 | PC30
14 | PC31
1 | PD0
132 | PD1
131 | PD2
128 | PD3
126 | PD4
125 | PD5
121 | PD6
119 | PD7
113 | PD8
110 | PD9
101 | PD10
98 | PD11
92 | PD12
88 | PD13
84 | PD14
106 | PD15
78 | PD16
74 | PD17
69 | PD18
67 | PD19
65 | PD20
63 | PD21
60 | PD22
57 | PD23
55 | PD24
52 | PD25
53 | PD26
47 | PD27
71 | PD28
108 | PD29
34 | PD30
2 | PD31
4 | PE0
6 | PE1
7 | PE2
10 | PE3
27 | PE4
28 | PE5
3 | VDDOUT
5 | VDDIN
8 | VREFN
9 | VREFP
83 | NRST
85 | TST
30,43,72, 80,96 | VDDIO
104 | JTAGSEL
29,33,50, 81,107 | VDDCORE
123 | VDDPLL
134 | VDDUTMII
136 | HSDM
137 | HSDP
44,61,95, 115,135,138 | GND
– | GNDANA
– | GNDUTMI
– | GNDPLLUSB
– | GNDPLL
139 | VDDUTMIC
140 | VBG
143 | VDDPLLUSB
LQFP Pin | Primary
 | Signal
1 | PD0
2 | PD31
3 | VDDOUT
4 | PE0
5 | VDDIN
6 | PE1
7 | PE2
8 | VREFN
9 | VREFP
10 | PE3
11 | PC0
12 | PC27
13 | PC26
14 | PC31
15 | PC30
16 | PC29
17 | PC12
18 | PC15
19 | PC13
20 | PB1
21 | PB0
22 | PA20
23 | PA19
24 | PA18
25 | PA17
26 | PB2
27 | PE4
28 | PE5
31 | PB3
32 | PA21
34 | PD30
35 | PA7
36 | PA8
37 | PA22
38 | PC1
39 | PC2
40 | PC3
41 | PC4
42 | PA13
45 | PA16
46 | PA23
47 | PD27
48 | PC7
49 | PA15
51 | PA14
52 | PD25
53 | PD26
54 | PC6
55 | PD24
56 | PA24
57 | PD23
58 | PC5
59 | PA25
60 | PD22
62 | PA26
63 | PD21
64 | PA11
65 | PD20
66 | PA10
67 | PD19
68 | PA12
69 | PD18
70 | PA27
71 | PD28
73 | PA5
74 | PD17
75 | PA9
76 | PC28
77 | PA4
78 | PD16
79 | PB6
82 | PC8
83 | NRST
84 | PD14
85 | TST
86 | PC9
87 | PB12
88 | PD13
89 | PB7
90 | PC10
91 | PA3
92 | PD12
93 | PA2
94 | PC11
97 | PC14
98 | PD11
99 | PA1
100 | PC16
101 | PD10
102 | PA0
103 | PC17
104 | JTAGSEL
105 | PB4
106 | PD15
108 | PD29
109 | PB5
110 | PD9
111 | PC18
112 | PA28
113 | PD8
114 | PA6
116 | PA30
117 | PC19
118 | PA31
119 | PD7
120 | PC20
121 | PD6
122 | PC21
123 | VDDPLL
124 | PC22
125 | PD5
126 | PD4
127 | PC23
128 | PD3
129 | PA29
130 | PC24
131 | PD2
132 | PD1
133 | PC25
134 | VDDUTMII
136 | HSDM
137 | HSDP
139 | VDDUTMIC
140 | VBG
141 | PB8
142 | PB9
143 | VDDPLLUSB
144 | PB13
– | GNDANA
– | GNDPLL
– | GNDPLLUSB
– | GNDUTMI
29,33,50, 81,107 | VDDCORE
30,43,72, 80,96 | VDDIO
44,61,95, 115,135,138 | GND
