kavionic/SAME70CPad/Schematics/SAME70CPad.kicad_pcb

## KiCad design Schematics/SAME70CPad.kicad_pcb (2018-01-13)

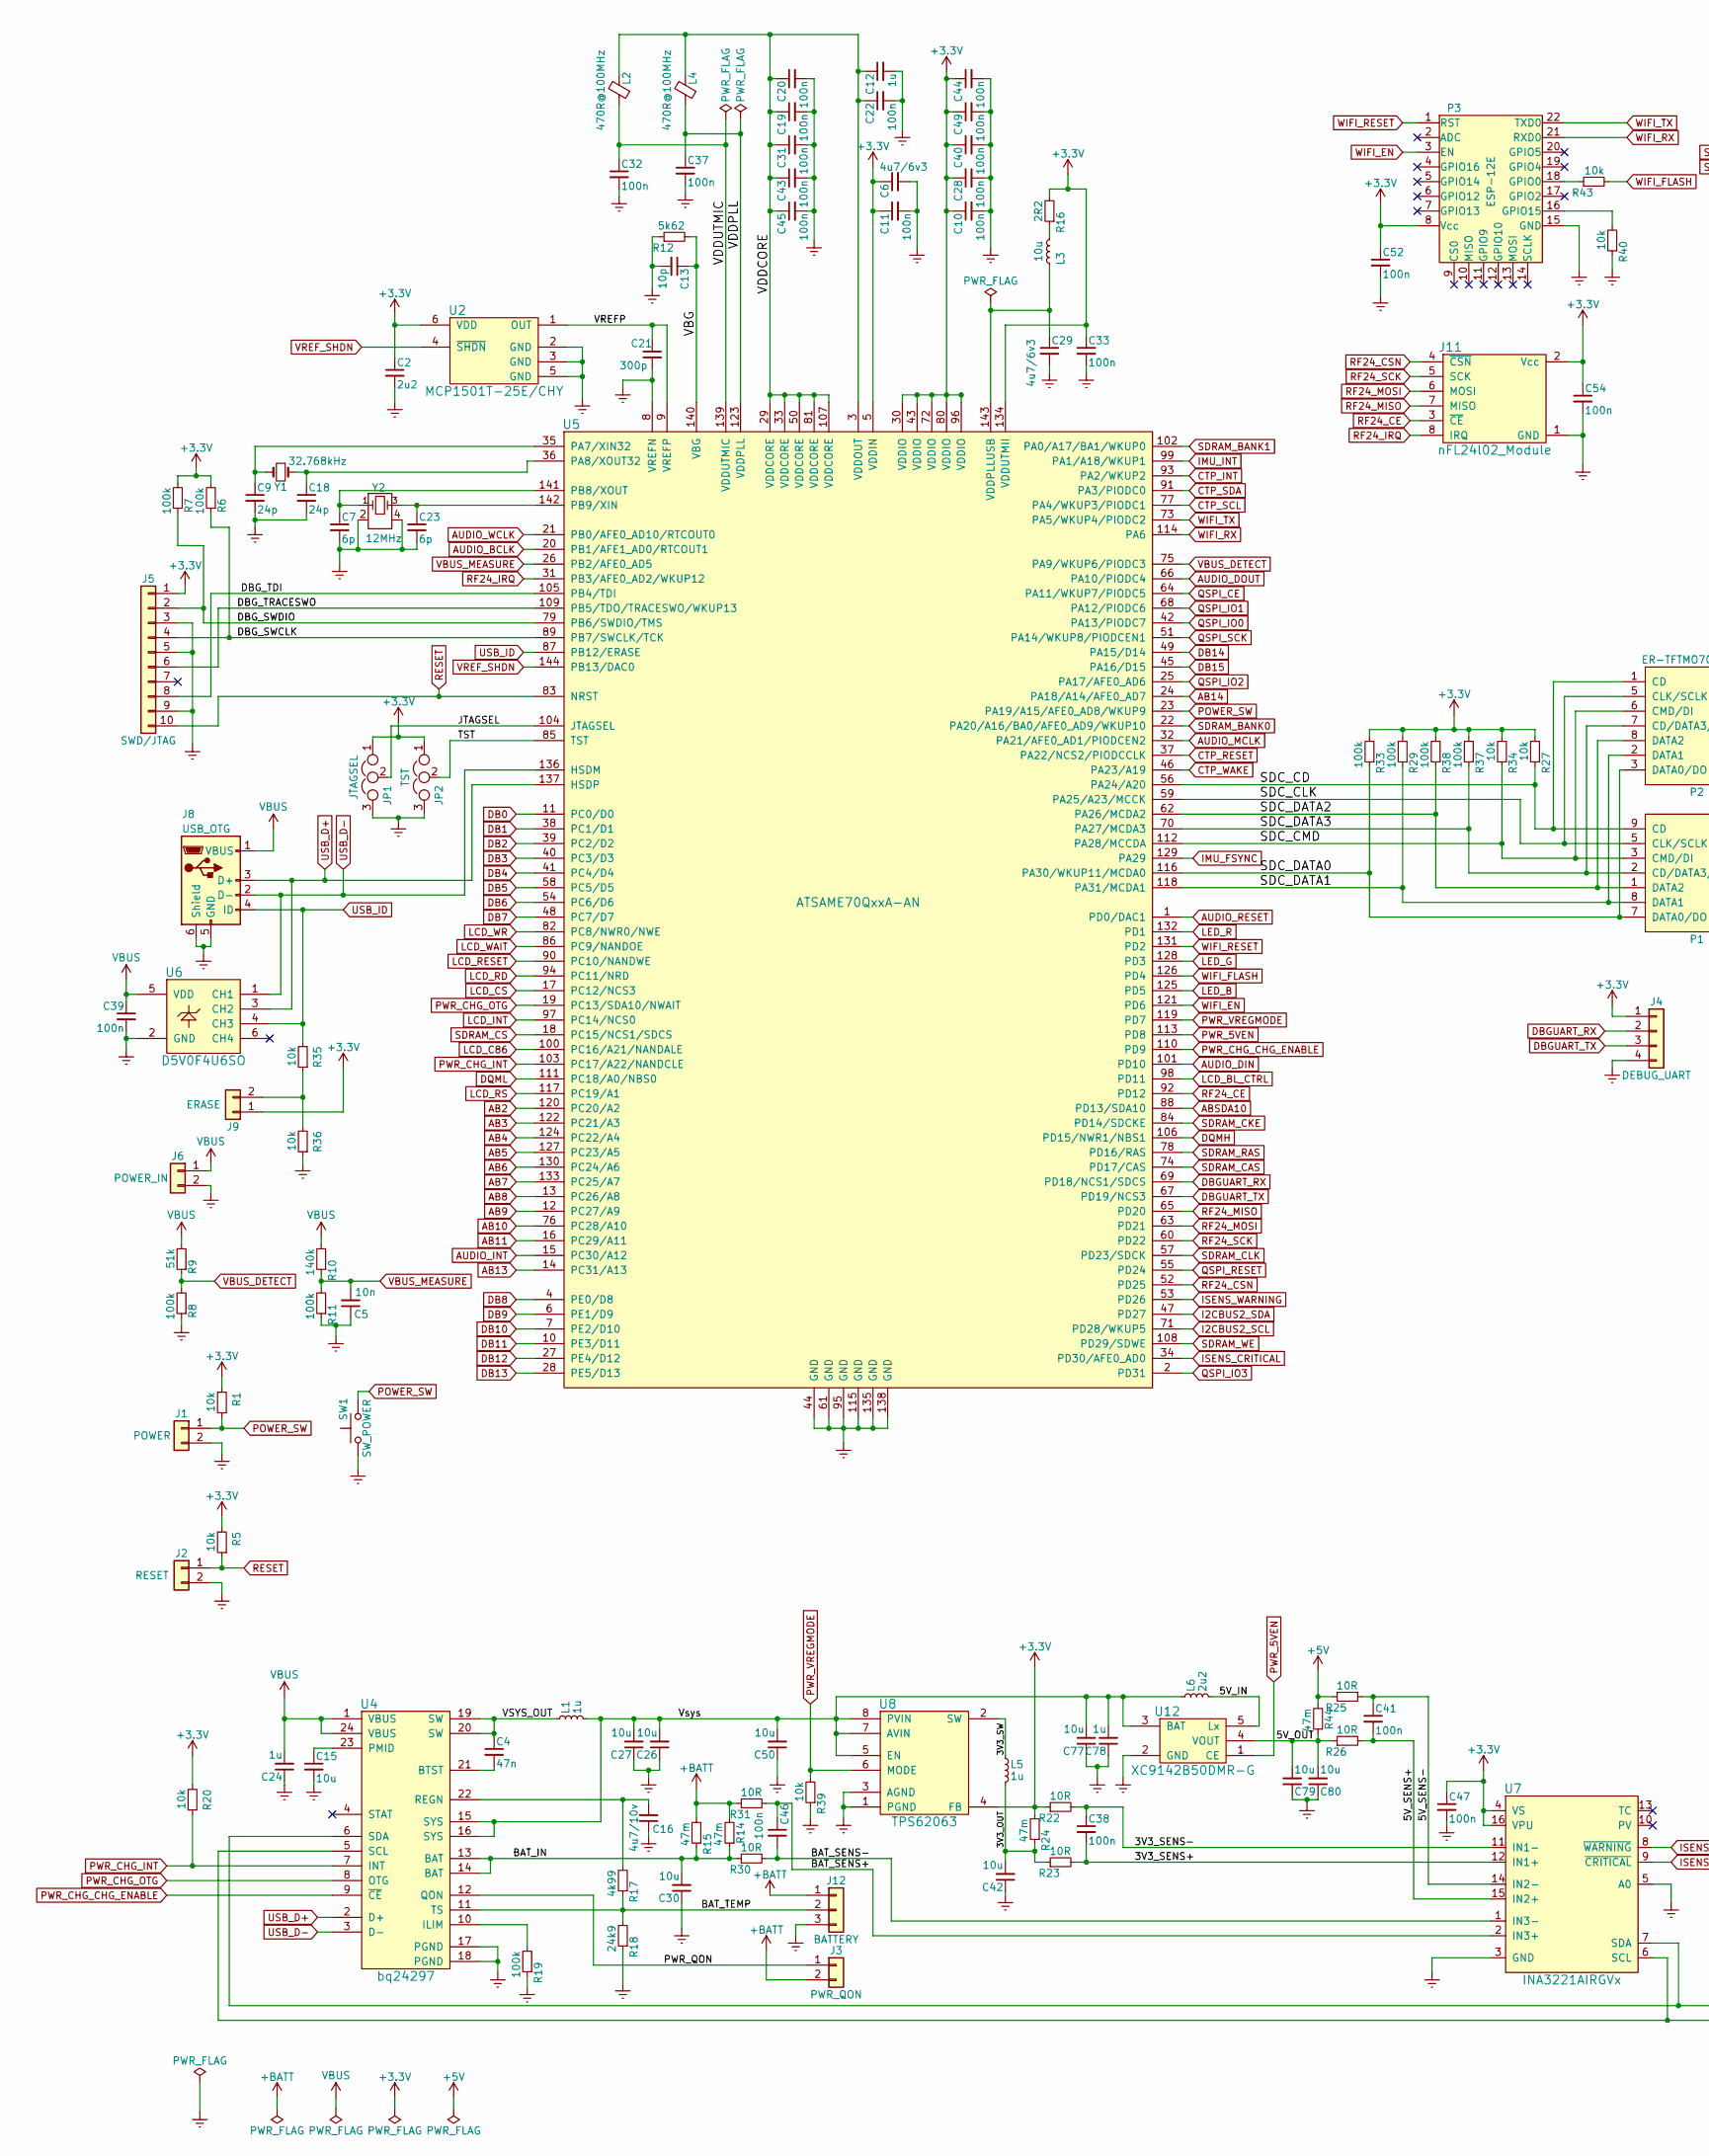
[picture p1: schematic SAME70CPad.sch, part in row 1, column 1]

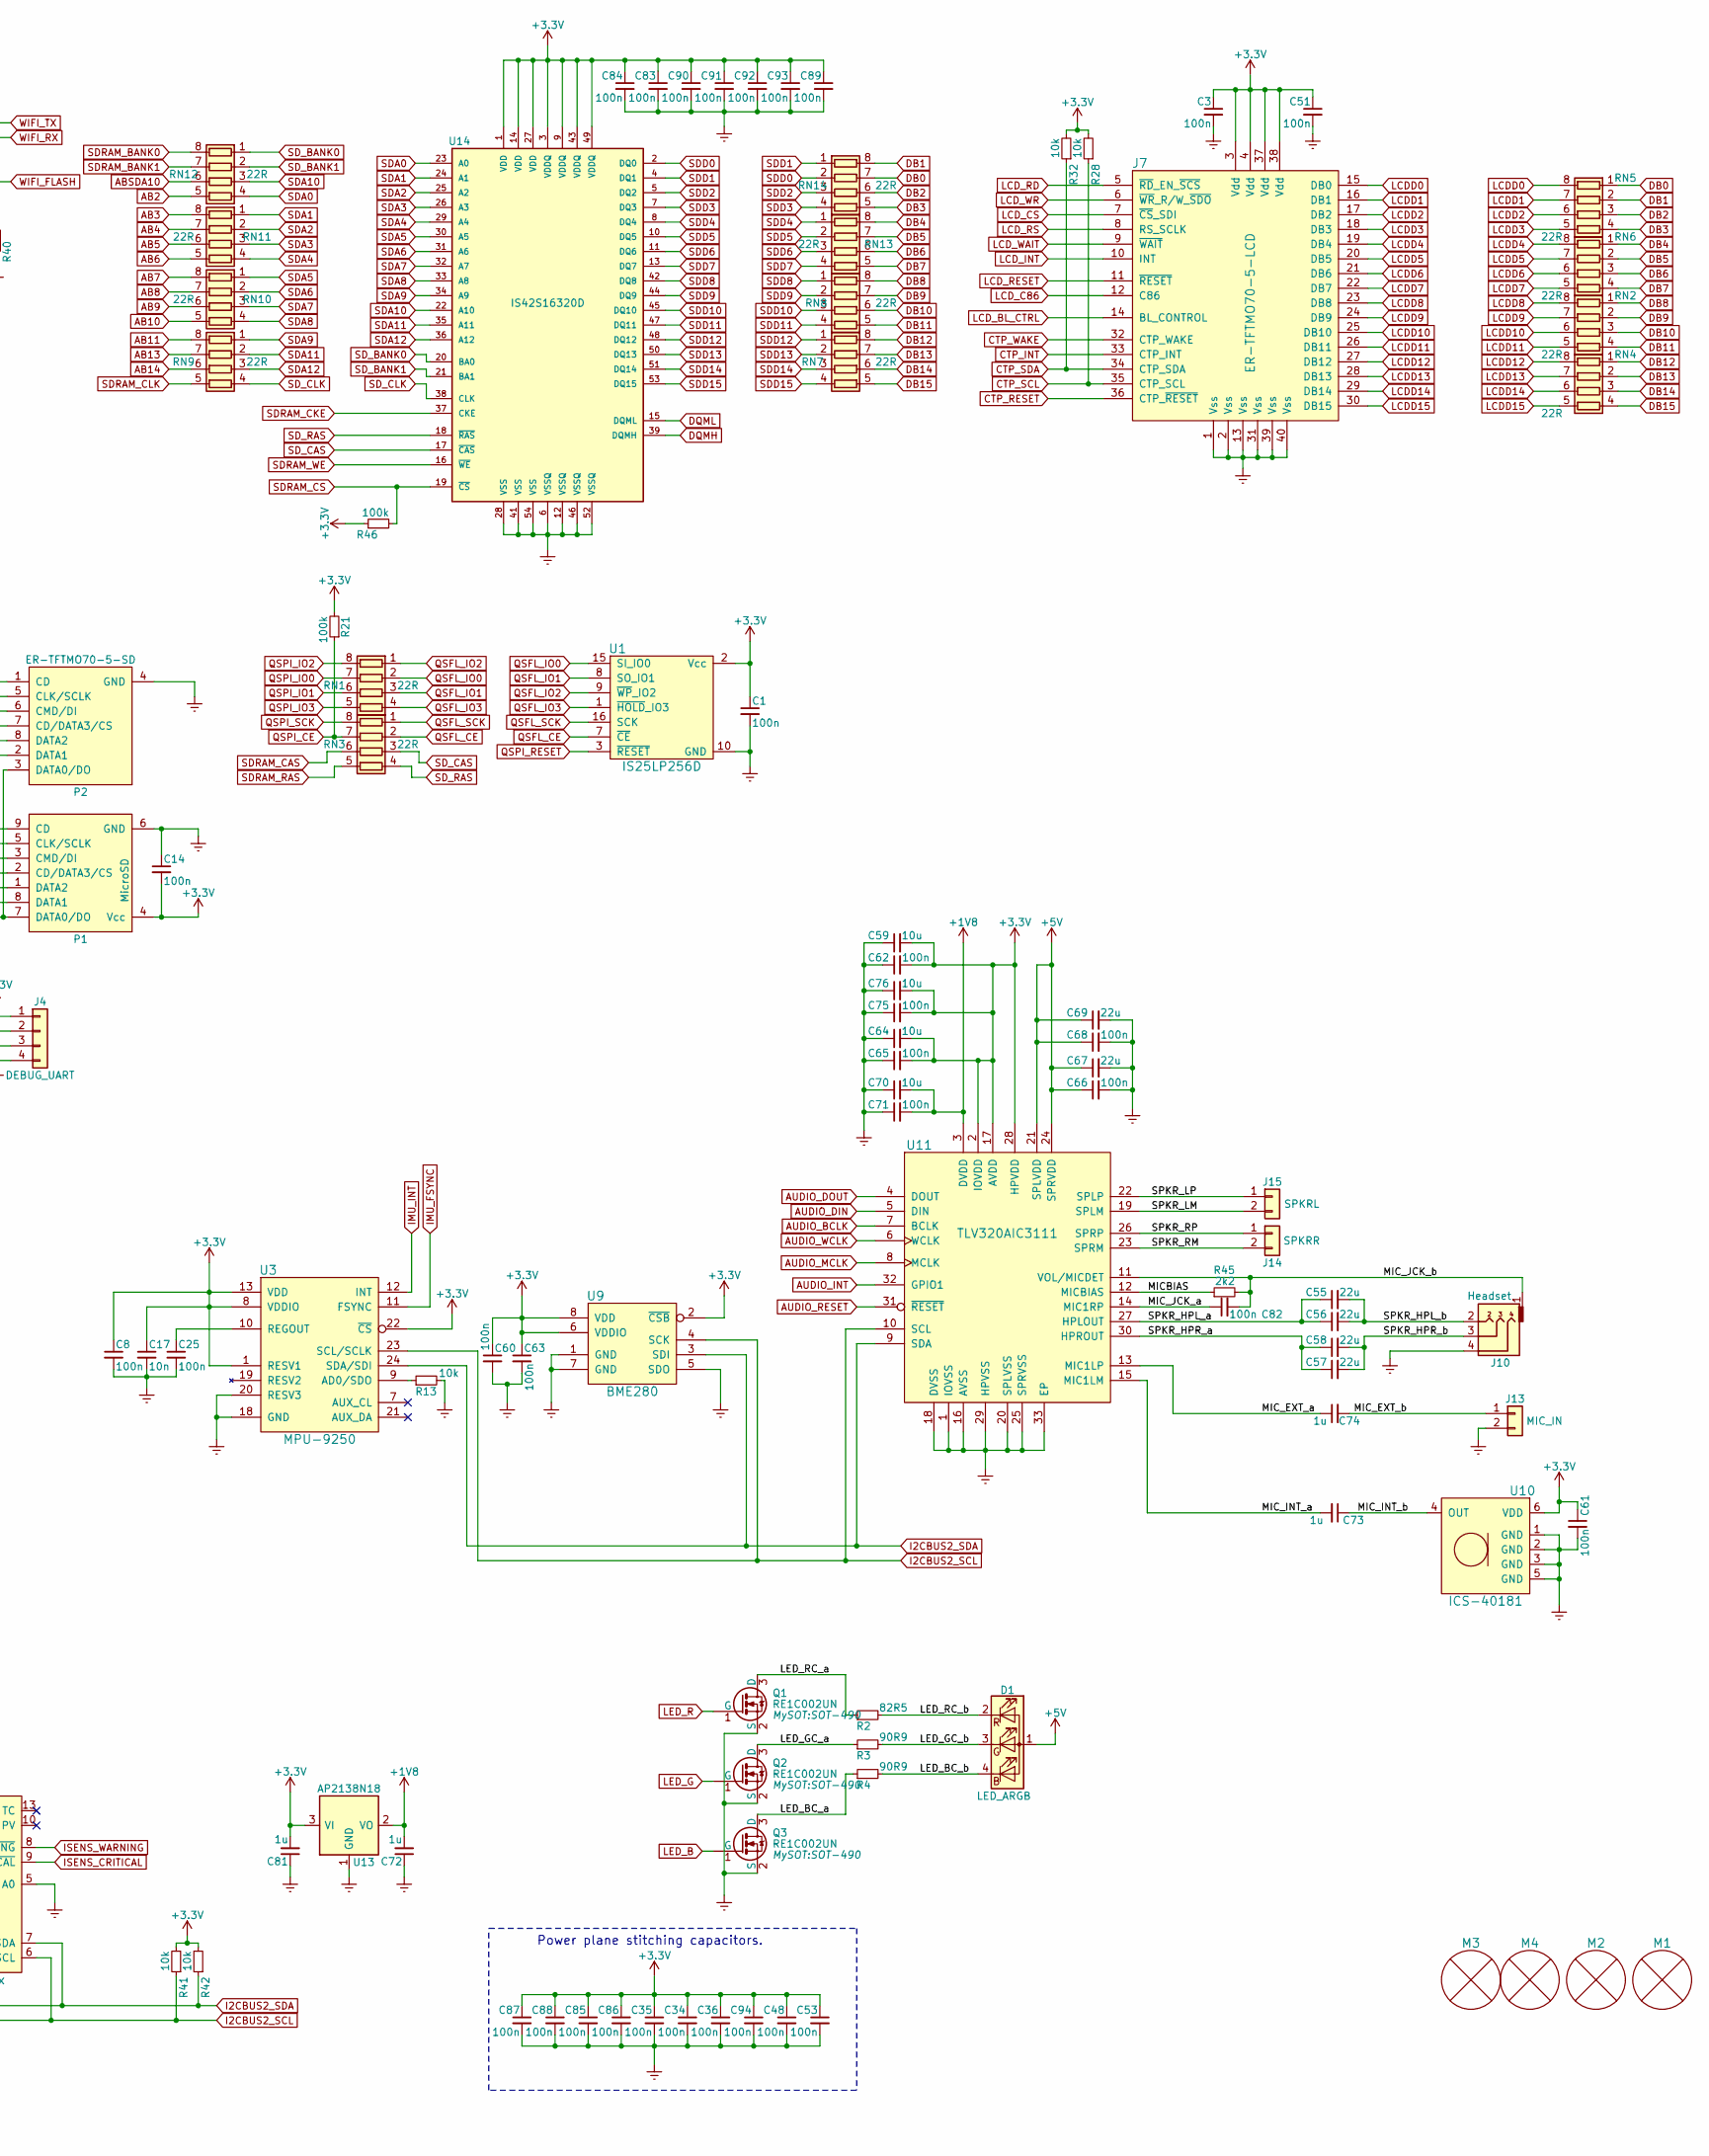
[picture p2: schematic SAME70CPad.sch, part in row 1, column 2]

Parts:
C1, C3, C8, C10, C11, C14, C19, C20, C22, C25, C28, C31, C32, C33, C34, C35, C36, C37, C38, C39, C40, C41, C43, C44, C45, C46, C47, C48, C49, C51, C52, C53, C54, C60, C61, C62, C63, C65, C66, C68, C71, C75, C82, C83, C84, C85, C86, C87, C88, C89, C90, C91, C92, C93, C94: 100n; C_0603
C2: 2u2; C_0603
C4: 47n; C_0603
C5, C17: 10n; C_0603
C6, C29: 4u7/6v3; C_0603
C7, C23: 6p; C_0603
C9, C18: 24p; C_0603
C12, C24, C72, C73, C74, C78, C81: 1u; C_0603
C13: 10p; C_0603
C15, C26, C27, C30, C42, C50, C59, C64, C70, C76, C77, C79, C80: 10u; C_0805
C16: 4u7/10v; C_0805
C21: 300p; C_0603
C55, C56, C57, C58, C67, C69: 22u; C_1206
D1: LED_ARGB; PLCC4_3228
J1: POWER; JST_ZH_S2B-ZR_02x1.50mm_Angled
J2: RESET; JST_ZH_S2B-ZR_02x1.50mm_Angled
J3: PWR_QON; JST_ZH_S2B-ZR_02x1.50mm_Angled
J4: DEBUG_UART; JST_ZH_S4B-ZR_04x1.50mm_Angled
J5: SWD/JTAG; BoxHeader_Straight_2x05_Pitch1.27mm
J6: POWER_IN; JST_EH_S02B-EH_02x2.50mm_Angled
J7: ER-TFTMO70-5-LCD; ER-CON40HB-2
J8: USB_OTG; USB_Micro-B_Molex-105017-0001
J9: ERASE; PinHeader_1x02
J10: Headset; SJ2-3514A-SMT
J11: nFL24l02_Module; nFL24l02_module
J12: BATTERY; JST_EH_S03B-EH_03x2.50mm_Angled
J13: MIC_IN; JST_ZH_S2B-ZR_02x1.50mm_Angled
J14: SPKRL; JST_ZH_S2B-ZR_02x1.50mm_Angled
J15: SPKRR; JST_ZH_S2B-ZR_02x1.50mm_Angled
JP1: JTAGSEL; PinHeader_1x03
JP2: TST; PinHeader_1x03
L1, L5: 1u; L_2020
L2, L4: 470R@100MHz; Choke_SMD_0603_Standard
L3: 10u; L_0805
L6: 2u2; L_2020
M1, M2, M3, M4: MountingHole; MH7x3
P1: MicroSD
P2: ER-TFTMO70-5-SD; ER-CON08HB-2
P3: ESP-12E
Q1, Q2, Q3: RE1C002UN; SOT-490
R1, R5, R13, R20, R27, R28, R32, R34, R35, R36, R39, R40, R41, R42, R43: 10k; R_0603
R2: 82R5; R_0603
R3, R4: 90R9; R_0603
R6, R7, R8, R11, R19, R21, R29, R33, R37, R38, R46: 100k; R_0603
R9: 51k; R_0603
R10: 140k; R_0603
R12: 5k62; R_0603
R14, R15, R24, R44: 47m; R_0603
R16: 2R2; R_0603
R17: 4k99; R_0603
R18: 24k9; R_0603
R22, R23, R25, R26, R30, R31: 10R; R_0603
R45: 2k2; R_0603
RN1, RN2, RN3, RN4, RN5, RN6, RN7, RN8, RN9, RN10, RN11, RN12, RN13, RN14: 22R; R_0402x4
SW1: SW_POWER; TactSwitch_TH_RightAngle_6.3x7.5x7.1mm_5.85mm
U1: IS25LP256D; SOIC-16_7.5x10.3mm_Pitch1.27mm
U2: MCP1501T-25E/CHY; SOT-23-6
U3: MPU-9250; QFN-24_3x3mm_Pitch0.4mm
U4: bq24297; QFN-24-1EP_4x4mm_Pitch0.5mm
U5: ATSAME70QxxA-AN; TQFP-144_20x20mm_Pitch0.5mm
U6: D5V0F4U6SO; SOT-23-6
U7: INA3221AIRGVx; QFN-16-1EP_4x4mm_Pitch0.65mm
U8: TPS62063; WSON-8_0.5mm_Pitch
U9: BME280
U10: ICS-40181
U11: TLV320AIC3111; QFN-32-1EP_5x5mm_Pitch0.5mm
U12: XC9142B50DMR-G; SOT-25
U13: AP2138N18; SOT-23
U14: IS42S16320D; TSOP-54
Y1: 32.768kHz; Crystal_SMD_3215-2pin_3.2x1.5mm
Y2: 12MHz; Crystal-5032

Connections:
+1V8: C70.2, C71.2, C72.2, U11.3 (DVDD), U13.2 (VO)
+3V3: C1.1, C2.1, C3.1, C6.1, C8.1, C10.1, C11.1, C14.2, C17.1, C28.1, C33.1, C34.1, C35.1, C36.1, C40.1, C44.1, C47.1, C48.1, C49.1, C51.1, C52.1, C53.1, C54.1, C59.2, C60.1, C61.1, C62.2, C63.1, C64.2, C65.2, C75.2, C76.2, C81.2, C83.1, C84.1, C85.1, C86.1, C87.1, C88.1, C89.1, C90.1, C91.1, C92.1, C93.1, C94.1, J4.1, J5.1, J7.3 (Vdd), J7.4 (Vdd), J7.37 (Vdd), J7.38 (Vdd), J9.1, J11.2 (Vcc), JP1.1, JP2.1, P1.4 (Vcc), P3.8 (Vcc), R1.2, R5.2, R6.2, R7.2, R16.2, R20.2, R21.2, R22.1, R24.2, R27.2, R28.2, R29.2, R32.2, R33.2, R34.2, R37.2, R38.2, R41.2, R42.2, R46.1, U1.2 (Vcc), U2.6 (VDD), U3.1 (RESV1), U3.8 (VDDIO), U3.13 (VDD), U3.22 (~CS), U5.5 (VDDIN), U5.30 (VDDIO), U5.43 (VDDIO), U5.72 (VDDIO), U5.80 (VDDIO), U5.96 (VDDIO), U5.134 (VDDUTMII), U7.4 (VS), U7.16 (VPU), U8.4 (FB), U9.2 (~CSB), U9.6 (VDDIO), U9.8 (VDD), U10.6 (VDD), U11.2 (IOVDD), U11.17 (AVDD), U11.28 (HPVDD), U13.3 (VI), U14.1 (VDD), U14.3 (VDDQ), U14.9 (VDDQ), U14.14 (VDD), U14.27 (VDD), U14.43 (VDDQ), U14.49 (VDDQ)
+5V: C66.1, C67.1, C68.1, C69.1, D1.1 (A), R25.1, R44.2, U11.21 (SPLVDD), U11.24 (SPRVDD)
+BATT: J3.2, J12.1, R14.2, R15.2, R31.1
/3V3_OUT: C42.2, L5.2, R23.1, R24.1
/3V3_SENS+: C38.2, R23.2, U7.12 (IN1+)
/3V3_SENS-: C38.1, R22.2, U7.11 (IN1-)
/3V3_SW: L5.1, U8.2 (SW)
/5V_IN: L6.2, U12.5 (Lx)
/5V_OUT: C79.2, C80.2, R26.1, R44.1, U12.4 (VOUT)
/5V_SENS+: C41.2, R26.2, U7.15 (IN2+)
/5V_SENS-: C41.1, R25.2, U7.14 (IN2-)
/BAT_IN: C30.2, R14.1, R15.1, R30.1, U4.13 (BAT), U4.14 (BAT)
/BAT_SENS+: C46.1, R31.2, U7.2 (IN3+)
/BAT_SENS-: C46.2, R30.2, U7.1 (IN3-)
/BAT_TEMP: J12.2, R17.1, R18.2, U4.11 (TS)
/DBG_SWCLK: J5.4, R6.1, U5.89 (PB7/SWCLK/TCK)
/DBG_SWDIO: J5.2, R7.1, U5.79 (PB6/SWDIO/TMS)
/DBG_TDI: J5.8, U5.105 (PB4/TDI)
/DBG_TRACESWO: J5.6, U5.109 (PB5/TDO/TRACESWO/WKUP13)
/JTAGSEL: JP1.2, U5.104 (JTAGSEL)
/LED_BC_a: Q3.3 (D), R4.1
/LED_BC_b: D1.4 (BK), R4.2
/LED_GC_a: Q2.3 (D), R3.1
/LED_GC_b: D1.3 (GK), R3.2
/LED_RC_a: Q1.3 (D), R2.1
/LED_RC_b: D1.2 (RK), R2.2
/MICBIAS: R45.1, U11.12 (MICBIAS)
/MIC_EXT_a: C74.1, U11.13 (MIC1LP)
/MIC_EXT_b: C74.2, J13.1
/MIC_INT_a: C73.2, U11.15 (MIC1LM)
/MIC_INT_b: C73.1, U10.4 (OUT)
/MIC_JCK_a: C82.1, U11.14 (MIC1RP)
/MIC_JCK_b: C82.2, J10.1, R45.2, U11.11 (VOL/MICDET)
/PWR_QON: J3.1, U4.12 (QON)
/SDC_CD: P1.9 (CD), P2.1 (CD), R27.1, U5.56 (PA24/A20)
/SDC_CLK: P1.5 (CLK/SCLK), P2.5 (CLK/SCLK), U5.59 (PA25/A23/MCCK)
/SDC_CMD: P1.3 (CMD/DI), P2.6 (CMD/DI), R34.1, U5.112 (PA28/MCCDA)
/SDC_DATA0: P1.7 (DATA0/DO), P2.3 (DATA0/DO), R33.1, U5.116 (PA30/WKUP11/MCDA0)
/SDC_DATA1: P1.8 (DATA1), P2.2 (DATA1), R29.1, U5.118 (PA31/MCDA1)
/SDC_DATA2: P1.1 (DATA2), P2.8 (DATA2), R38.1, U5.62 (PA26/MCDA2)
/SDC_DATA3: P1.2 (CD/DATA3/CS), P2.7 (CD/DATA3/CS), R37.1, U5.70 (PA27/MCDA3)
/SPKR_HPL_a: C55.1, C56.1, U11.27 (HPLOUT)
/SPKR_HPL_b: C55.2, C56.2, J10.2
/SPKR_HPR_a: C57.1, C58.1, U11.30 (HPROUT)
/SPKR_HPR_b: C57.2, C58.2, J10.3
/SPKR_LM: J14.2, U11.19 (SPLM)
/SPKR_LP: J14.1, U11.22 (SPLP)
/SPKR_RM: J15.2, U11.23 (SPRM)
/SPKR_RP: J15.1, U11.26 (SPRP)
/TST: JP2.2, U5.85 (TST)
/VBG: C13.1, R12.2, U5.140 (VBG)
/VDDCORE: C12.1, C19.1, C20.1, C22.1, C31.1, C43.1, C45.1, L2.2, L4.2, U5.3 (VDDOUT), U5.29 (VDDCORE), U5.33 (VDDCORE), U5.50 (VDDCORE), U5.81 (VDDCORE), U5.107 (VDDCORE)
/VDDPLL: C37.1, L4.1, U5.123 (VDDPLL)
/VDDUTMIC: C32.1, L2.1, U5.139 (VDDUTMIC)
/VREFP: C21.1, U2.1 (OUT), U5.9 (VREFP)
/VSYS_OUT: C4.1, L1.1, U4.19 (SW), U4.20 (SW)
/Vsys: C26.2, C27.2, C50.2, C77.2, C78.2, L1.2, L6.1, U4.15 (SYS), U4.16 (SYS), U8.5 (EN), U8.7 (AVIN), U8.8 (PVIN), U12.3 (BAT)
AB2: RN12.5 (R4.2), U5.120 (PC20/A2)
AB3: RN11.8 (R1.2), U5.122 (PC21/A3)
AB4: RN11.7 (R2.2), U5.124 (PC22/A4)
AB5: RN11.6 (R3.2), U5.127 (PC23/A5)
AB6: RN11.5 (R4.2), U5.130 (PC24/A6)
AB7: RN10.8 (R1.2), U5.133 (PC25/A7)
AB8: RN10.7 (R2.2), U5.13 (PC26/A8)
AB9: RN10.6 (R3.2), U5.12 (PC27/A9)
AB10: RN10.5 (R4.2), U5.76 (PC28/A10)
AB11: RN9.8 (R1.2), U5.16 (PC29/A11)
AB13: RN9.7 (R2.2), U5.14 (PC31/A13)
AB14: RN9.6 (R3.2), U5.24 (PA18/A14/AFE0_AD7)
ABSDA10: RN12.6 (R3.2), U5.88 (PD13/SDA10)
AUDIO_BCLK: U5.20 (PB1/AFE1_AD0/RTCOUT1), U11.7 (BCLK)
AUDIO_DIN: U5.101 (PD10), U11.5 (DIN)
AUDIO_DOUT: U5.66 (PA10/PIODC4), U11.4 (DOUT)
AUDIO_INT: U5.15 (PC30/A12), U11.32 (GPIO1)
AUDIO_MCLK: U5.32 (PA21/AFE0_AD1/PIODCEN2), U11.8 (MCLK)
AUDIO_RESET: U5.1 (PD0/DAC1), U11.31 (~RESET)
AUDIO_WCLK: U5.21 (PB0/AFE0_AD10/RTCOUT0), U11.6 (WCLK)
CTP_INT: J7.33 (CTP_INT), U5.93 (PA2/WKUP2)
CTP_RESET: J7.36 (CTP_~RESET), U5.37 (PA22/NCS2/PIODCCLK)
CTP_SCL: J7.35 (CTP_SCL), R28.1, U5.77 (PA4/WKUP3/PIODC1)
CTP_SDA: J7.34 (CTP_SDA), R32.1, U5.91 (PA3/PIODC0)
CTP_WAKE: J7.32 (CTP_WAKE), U5.46 (PA23/A19)
DB0: RN5.1 (R1.1), RN14.7 (R2.2), U5.11 (PC0/D0)
DB1: RN5.2 (R2.1), RN14.8 (R1.2), U5.38 (PC1/D1)
DB2: RN5.3 (R3.1), RN14.6 (R3.2), U5.39 (PC2/D2)
DB3: RN5.4 (R4.1), RN14.5 (R4.2), U5.40 (PC3/D3)
DB4: RN6.1 (R1.1), RN13.8 (R1.2), U5.41 (PC4/D4)
DB5: RN6.2 (R2.1), RN13.7 (R2.2), U5.58 (PC5/D5)
DB6: RN6.3 (R3.1), RN13.6 (R3.2), U5.54 (PC6/D6)
DB7: RN6.4 (R4.1), RN13.5 (R4.2), U5.48 (PC7/D7)
DB8: RN2.1 (R1.1), RN8.8 (R1.2), U5.4 (PE0/D8)
DB9: RN2.2 (R2.1), RN8.7 (R2.2), U5.6 (PE1/D9)
DB10: RN2.3 (R3.1), RN8.6 (R3.2), U5.7 (PE2/D10)
DB11: RN2.4 (R4.1), RN8.5 (R4.2), U5.10 (PE3/D11)
DB12: RN4.1 (R1.1), RN7.8 (R1.2), U5.27 (PE4/D12)
DB13: RN4.2 (R2.1), RN7.7 (R2.2), U5.28 (PE5/D13)
DB14: RN4.3 (R3.1), RN7.6 (R3.2), U5.49 (PA15/D14)
DB15: RN4.4 (R4.1), RN7.5 (R4.2), U5.45 (PA16/D15)
DBGUART_RX: J4.2, U5.69 (PD18/NCS1/SDCS)
DBGUART_TX: J4.3, U5.67 (PD19/NCS3)
DQMH: U5.106 (PD15/NWR1/NBS1), U14.39 (DQMH)
DQML: U5.111 (PC18/A0/NBS0), U14.15 (DQML)
Earth: C1.2, C2.2, C3.2, C5.1, C6.2, C7.2, C8.2, C9.2, C10.2, C11.2, C12.2, C13.2, C14.1, C15.2, C16.1, C17.2, C18.2, C19.2, C20.2, C21.2, C22.2, C23.2, C24.1, C25.2, C26.1, C27.1, C28.2, C29.2, C30.1, C31.2, C32.2, C33.2, C34.2, C35.2, C36.2, C37.2, C39.2, C40.2, C42.1, C43.2, C44.2, C45.2, C47.2, C48.2, C49.2, C50.1, C51.2, C52.2, C53.2, C54.2, C59.1, C60.2, C61.2, C62.1, C63.2, C64.1, C65.1, C66.2, C67.2, C68.2, C69.2, C70.1, C71.1, C72.1, C75.1, C76.1, C77.1, C78.1, C79.1, C80.1, C81.1, C83.2, C84.2, C85.2, C86.2, C87.2, C88.2, C89.2, C90.2, C91.2, C92.2, C93.2, C94.2, J1.2, J2.2, J4.4, J5.3, J5.5, J5.9, J6.2, J7.1 (Vss), J7.2 (Vss), J7.13 (Vss), J7.31 (Vss), J7.39 (Vss), J7.40 (Vss), J8.5 (GND), J8.6 (Shield), J10.4, J11.1 (GND), J12.3, J13.2, JP1.3, JP2.3, P1.6 (GND), P1.10 (GND), P1.11 (GND), P1.12 (GND), P1.13 (GND), P2.4 (GND), P3.15 (GND), Q1.2 (S), Q2.2 (S), Q3.2 (S), R8.1, R11.1, R12.1, R13.2, R18.1, R19.1, R36.1, R39.1, R40.1, SW1.1, U1.10 (GND), U2.2 (GND), U2.3 (GND), U2.5 (GND), U3.18 (GND), U3.20 (RESV3), U4.17 (PGND), U4.18 (PGND), U4.25 (PGND), U5.8 (VREFN), U5.44 (GND), U5.61 (GND), U5.95 (GND), U5.115 (GND), U5.135 (GND), U5.138 (GND), U6.2 (GND), U7.3 (GND), U7.5 (A0), U7.17 (GND), U8.1 (PGND), U8.3 (AGND), U8.9 (PGND), U9.1 (GND), U9.5 (SDO), U9.7 (GND), U10.1 (GND), U10.2 (GND), U10.3 (GND), U10.5 (GND), U11.1 (IOVSS), U11.16 (AVSS), U11.18 (DVSS), U11.20 (SPLVSS), U11.25 (SPRVSS), U11.29 (HPVSS), U11.33 (EP), U12.2 (GND), U13.1 (GND), U14.6 (VSSQ), U14.12 (VSSQ), U14.28 (VSS), U14.41 (VSS), U14.46 (VSSQ), U14.52 (VSSQ), U14.54 (VSS), Y2.2 (NC), Y2.4 (NC)
I2CBUS2_SCL: R41.1, U3.23 (SCL/SCLK), U4.5 (SCL), U5.71 (PD28/WKUP5), U7.6 (SCL), U9.4 (SCK), U11.10 (SCL)
I2CBUS2_SDA: R42.1, U3.24 (SDA/SDI), U4.6 (SDA), U5.47 (PD27), U7.7 (SDA), U9.3 (SDI), U11.9 (SDA)
IMU_FSYNC: U3.11 (FSYNC), U5.129 (PA29)
IMU_INT: U3.12 (INT), U5.99 (PA1/A18/WKUP1)
ISENS_CRITICAL: U5.34 (PD30/AFE0_AD0), U7.9 (~CRITICAL)
ISENS_WARNING: U5.53 (PD26), U7.8 (~WARNING)
LCDD0: J7.15 (DB0), RN5.8 (R1.2)
LCDD1: J7.16 (DB1), RN5.7 (R2.2)
LCDD2: J7.17 (DB2), RN5.6 (R3.2)
LCDD3: J7.18 (DB3), RN5.5 (R4.2)
LCDD4: J7.19 (DB4), RN6.8 (R1.2)
LCDD5: J7.20 (DB5), RN6.7 (R2.2)
LCDD6: J7.21 (DB6), RN6.6 (R3.2)
LCDD7: J7.22 (DB7), RN6.5 (R4.2)
LCDD8: J7.23 (DB8), RN2.8 (R1.2)
LCDD9: J7.24 (DB9), RN2.7 (R2.2)
LCDD10: J7.25 (DB10), RN2.6 (R3.2)
LCDD11: J7.26 (DB11), RN2.5 (R4.2)
LCDD12: J7.27 (DB12), RN4.8 (R1.2)
LCDD13: J7.28 (DB13), RN4.7 (R2.2)
LCDD14: J7.29 (DB14), RN4.6 (R3.2)
LCDD15: J7.30 (DB15), RN4.5 (R4.2)
LCD_BL_CTRL: J7.14 (BL_CONTROL), U5.98 (PD11)
LCD_C86: J7.12 (C86), U5.100 (PC16/A21/NANDALE)
LCD_CS: J7.7 (~CS~_SDI), U5.17 (PC12/NCS3)
LCD_INT: J7.10 (INT), U5.97 (PC14/NCS0)
LCD_RD: J7.5 (~RD~_EN_~SCS), U5.94 (PC11/NRD)
LCD_RESET: J7.11 (~RESET), U5.90 (PC10/NANDWE)
LCD_RS: J7.8 (RS_SCLK), U5.117 (PC19/A1)
LCD_WAIT: J7.9 (~WAIT), U5.86 (PC9/NANDOE)
LCD_WR: J7.6 (~WR~_R/W_~SDO), U5.82 (PC8/NWR0/NWE)
LED_B: Q3.1 (G), U5.125 (PD5)
LED_G: Q2.1 (G), U5.128 (PD3)
LED_R: Q1.1 (G), U5.132 (PD1)
unnamed: C4.2, U4.21 (BTST)
unnamed: C7.1, U5.141 (PB8/XOUT), Y2.1 (X1)
unnamed: C9.1, U5.35 (PA7/XIN32), Y1.2
unnamed: C15.1, U4.23 (PMID)
unnamed: C16.2, R17.2, U4.22 (REGN)
unnamed: C18.1, U5.36 (PA8/XOUT32), Y1.1
unnamed: C23.1, U5.142 (PB9/XIN), Y2.3 (X2)
unnamed: C25.1, U3.10 (REGOUT)
unnamed: C29.1, L3.1, U5.143 (VDDPLLUSB)
unnamed: J9.2, R35.1, R36.2
unnamed: L3.2, R16.1
unnamed: P3.16 (GPIO15), R40.2
unnamed: P3.18 (GPIO0), R43.1
unnamed: R13.1, U3.9 (AD0/SDO)
unnamed: R19.2, U4.10 (ILIM)
POWER_SW: J1.1, R1.1, SW1.2, U5.23 (PA19/A15/AFE0_AD8/WKUP9)
PWR_5VEN: U5.113 (PD8), U12.1 (CE)
PWR_CHG_CHG_ENABLE: U4.9 (~CE), U5.110 (PD9)
PWR_CHG_INT: R20.1, U4.7 (INT), U5.103 (PC17/A22/NANDCLE)
PWR_CHG_OTG: U4.8 (OTG), U5.19 (PC13/SDA10/NWAIT)
PWR_VREGMODE: R39.2, U5.119 (PD7), U8.6 (MODE)
QSFL_CE: RN3.2 (R2.1), U1.7 (~CE)
QSFL_IO0: RN1.2 (R2.1), U1.15 (SI_IO0)
QSFL_IO1: RN1.3 (R3.1), U1.8 (SO_IO1)
QSFL_IO2: RN1.1 (R1.1), U1.9 (~WP~_IO2)
QSFL_IO3: RN1.4 (R4.1), U1.1 (~HOLD~_IO3)
QSFL_SCK: RN3.1 (R1.1), U1.16 (SCK)
QSPI_CE: R21.1, RN3.7 (R2.2), U5.64 (PA11/WKUP7/PIODC5)
QSPI_IO0: RN1.7 (R2.2), U5.42 (PA13/PIODC7)
QSPI_IO1: RN1.6 (R3.2), U5.68 (PA12/PIODC6)
QSPI_IO2: RN1.8 (R1.2), U5.25 (PA17/AFE0_AD6)
QSPI_IO3: RN1.5 (R4.2), U5.2 (PD31)
QSPI_RESET: U1.3 (~RESET), U5.55 (PD24)
QSPI_SCK: RN3.8 (R1.2), U5.51 (PA14/WKUP8/PIODCEN1)
RESET: J2.1, J5.10, R5.1, U5.83 (NRST)
RF24_CE: J11.3 (~CE), U5.92 (PD12)
RF24_CSN: J11.4 (~CSN), U5.52 (PD25)
RF24_IRQ: J11.8 (IRQ), U5.31 (PB3/AFE0_AD2/WKUP12)
RF24_MISO: J11.7 (MISO), U5.65 (PD20)
RF24_MOSI: J11.6 (MOSI), U5.63 (PD21)
RF24_SCK: J11.5 (SCK), U5.60 (PD22)
SDA0: RN12.4 (R4.1), U14.23 (A0)
SDA1: RN11.1 (R1.1), U14.24 (A1)
SDA2: RN11.2 (R2.1), U14.25 (A2)
SDA3: RN11.3 (R3.1), U14.26 (A3)
SDA4: RN11.4 (R4.1), U14.29 (A4)
SDA5: RN10.1 (R1.1), U14.30 (A5)
SDA6: RN10.2 (R2.1), U14.31 (A6)
SDA7: RN10.3 (R3.1), U14.32 (A7)
SDA8: RN10.4 (R4.1), U14.33 (A8)
SDA9: RN9.1 (R1.1), U14.34 (A9)
SDA10: RN12.3 (R3.1), U14.22 (A10)
SDA11: RN9.2 (R2.1), U14.35 (A11)
SDA12: RN9.3 (R3.1), U14.36 (A12)
SDD0: RN14.2 (R2.1), U14.2 (DQ0)
SDD1: RN14.1 (R1.1), U14.4 (DQ1)
SDD2: RN14.3 (R3.1), U14.5 (DQ2)
SDD3: RN14.4 (R4.1), U14.7 (DQ3)
SDD4: RN13.1 (R1.1), U14.8 (DQ4)
SDD5: RN13.2 (R2.1), U14.10 (DQ5)
SDD6: RN13.3 (R3.1), U14.11 (DQ6)
SDD7: RN13.4 (R4.1), U14.13 (DQ7)
SDD8: RN8.1 (R1.1), U14.42 (DQ8)
SDD9: RN8.2 (R2.1), U14.44 (DQ9)
SDD10: RN8.3 (R3.1), U14.45 (DQ10)
SDD11: RN8.4 (R4.1), U14.47 (DQ11)
SDD12: RN7.1 (R1.1), U14.48 (DQ12)
SDD13: RN7.2 (R2.1), U14.50 (DQ13)
SDD14: RN7.3 (R3.1), U14.51 (DQ14)
SDD15: RN7.4 (R4.1), U14.53 (DQ15)
SDRAM_BANK0: RN12.8 (R1.2), U5.22 (PA20/A16/BA0/AFE0_AD9/WKUP10)
SDRAM_BANK1: RN12.7 (R2.2), U5.102 (PA0/A17/BA1/WKUP0)
SDRAM_CAS: RN3.6 (R3.2), U5.74 (PD17/CAS)
SDRAM_CKE: U5.84 (PD14/SDCKE), U14.37 (CKE)
SDRAM_CLK: RN9.5 (R4.2), U5.57 (PD23/SDCK)
SDRAM_CS: R46.2, U5.18 (PC15/NCS1/SDCS), U14.19 (~CS~)
SDRAM_RAS: RN3.5 (R4.2), U5.78 (PD16/RAS)
SDRAM_WE: U5.108 (PD29/SDWE), U14.16 (~WE~)
SD_BANK0: RN12.1 (R1.1), U14.20 (BA0)
SD_BANK1: RN12.2 (R2.1), U14.21 (BA1)
SD_CAS: RN3.3 (R3.1), U14.17 (~CAS~)
SD_CLK: RN9.4 (R4.1), U14.38 (CLK)
SD_RAS: RN3.4 (R4.1), U14.18 (~RAS~)
USB_D+: J8.3 (D+), U4.2 (D+), U5.137 (HSDP), U6.3 (CH2)
USB_D-: J8.2 (D-), U4.3 (D-), U5.136 (HSDM), U6.1 (CH1)
USB_ID: J8.4 (ID), R35.2, U5.87 (PB12/ERASE), U6.4 (CH3)
VBUS: C24.2, C39.1, J6.1, J8.1 (VBUS), R9.2, R10.2, U4.1 (VBUS), U4.24 (VBUS), U6.5 (VDD)
VBUS_DETECT: R8.2, R9.1, U5.75 (PA9/WKUP6/PIODC3)
VBUS_MEASURE: C5.2, R10.1, R11.2, U5.26 (PB2/AFE0_AD5)
VREF_SHDN: U2.4 (~SHDN), U5.144 (PB13/DAC0)
WIFI_EN: P3.3 (EN), U5.121 (PD6)
WIFI_FLASH: R43.2, U5.126 (PD4)
WIFI_RESET: P3.1 (RST), U5.131 (PD2)
WIFI_RX: P3.21 (RXD0), U5.114 (PA6)
WIFI_TX: P3.22 (TXD0), U5.73 (PA5/WKUP4/PIODC2)

Notes on the sheet:
Power plane stitching capacitors.

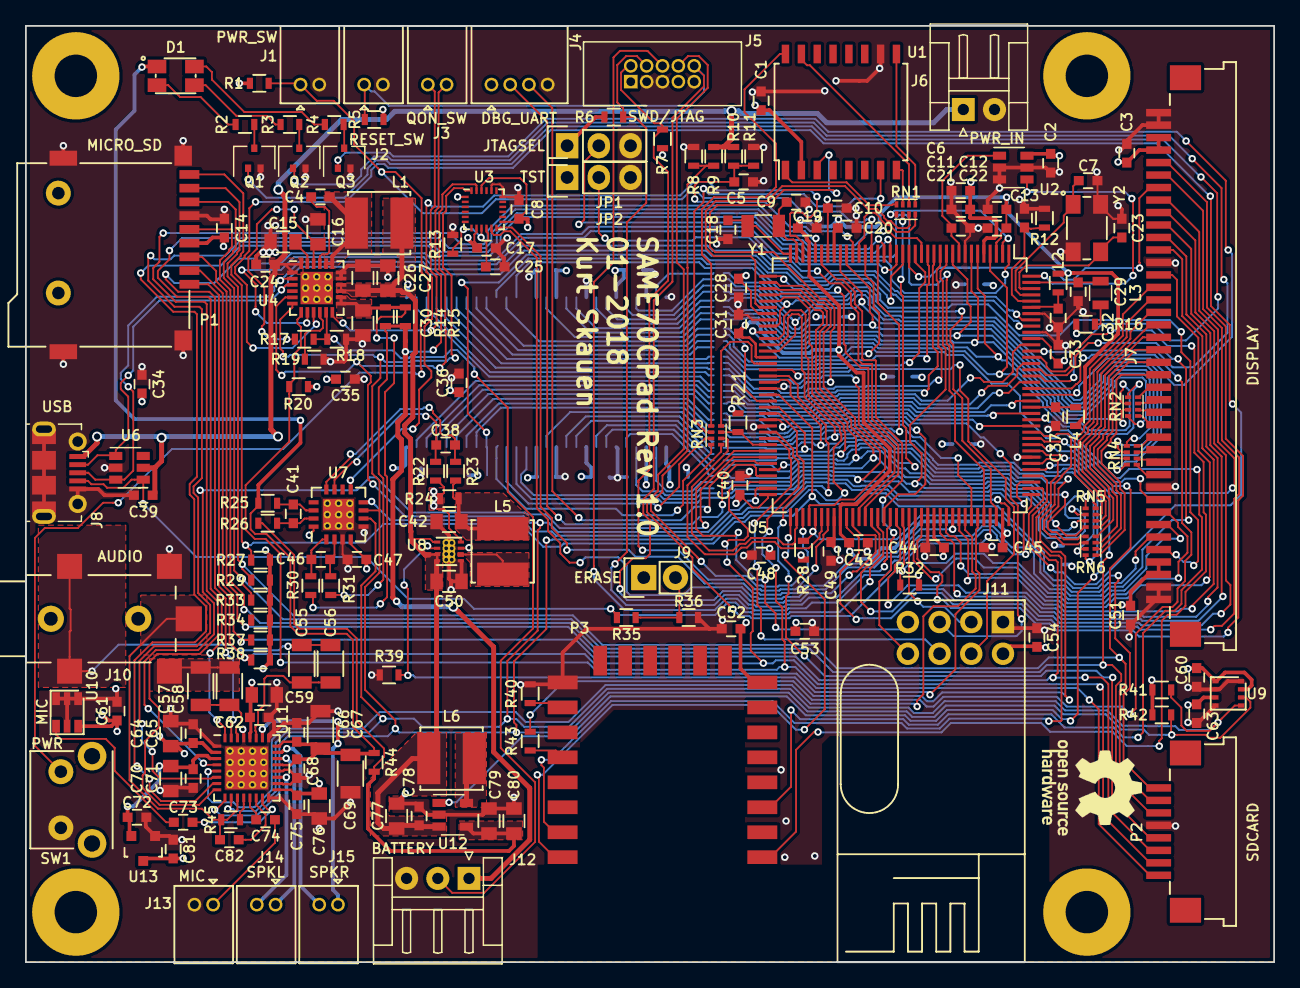
[picture p3: board SAME70CPad.kicad_pcb from above]

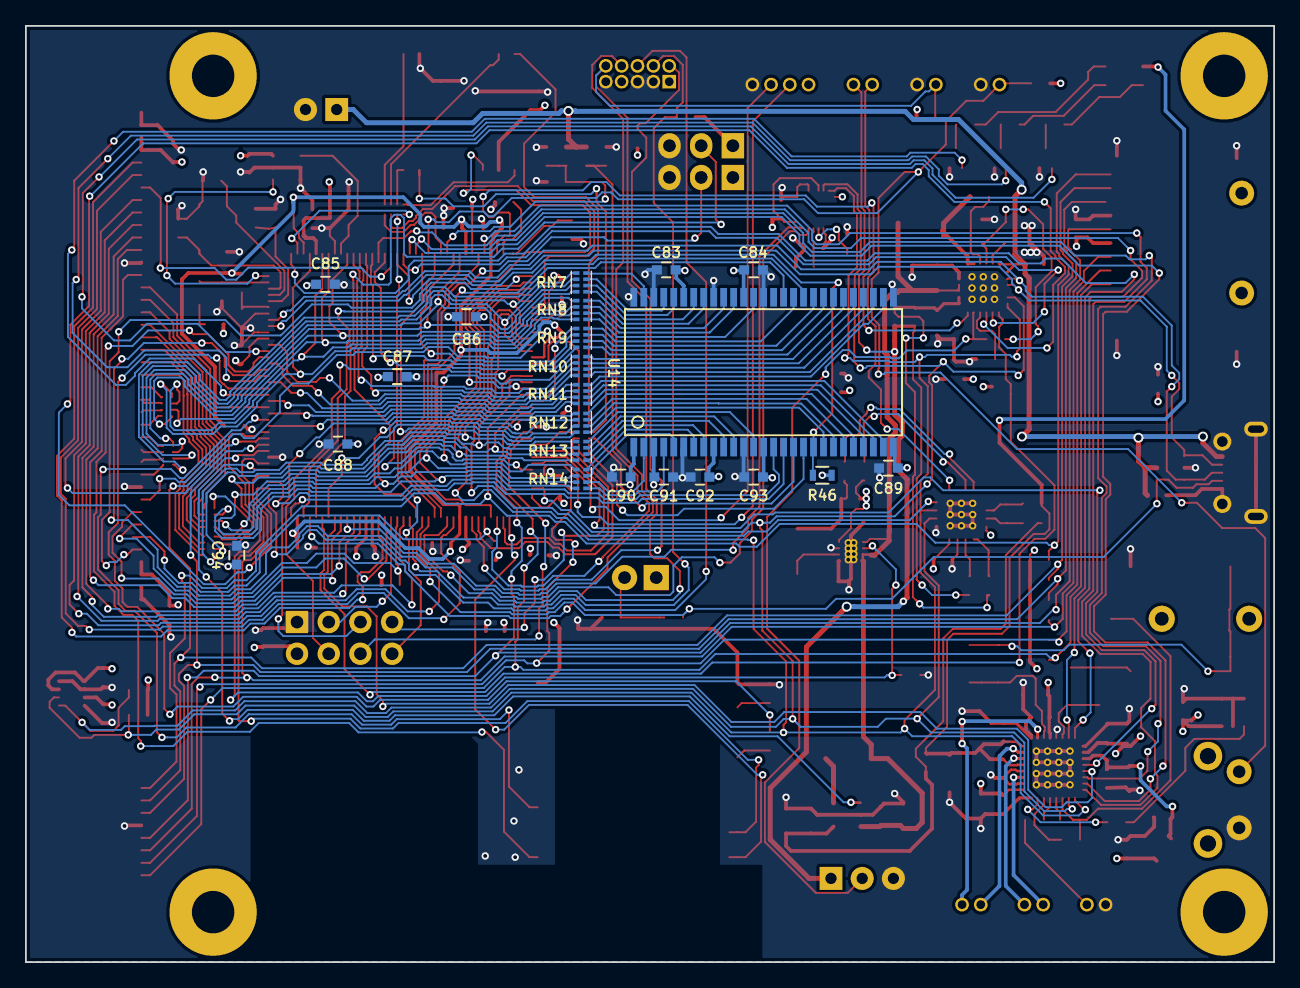
[picture p4: board SAME70CPad.kicad_pcb from below]

Board: 4 copper layers, 100.0 x 75.0 mm, 205 parts (22 on the bottom side), 233 nets.
