kavionic/SAME70CPad/(commit log)

2018-01-12 Initial version of SAME70CPad.
    [Notes.ods, SAME70CPad.kicad_pcb, SAME70CPad.sch]
2018-01-13 Added some missing pullup resistors plus misc cleanup and optimization of the layout.
    [Notes.ods, SAME70CPad.kicad_pcb, SAME70CPad.sch]
2018-01-13 - Annotated components geographically from the PCB layout. - Added the OSHW logo to the PCB. - Some minor layout cleanup.
    [SAME70CPad.kicad_pcb, SAME70CPad.sch]
